hra1129/V9968_Cartridge/readme.md

# 概要
MSX2++用のVDP「V9968」の開発用リポジトリです。

# LICENSE
MIT License

# 免責事項
自動車等の乗り物や、医療、軍事等、人命にかかわるようなものへ、
一部または全部を転用する行為は厳禁です。
