hra1129/V9968_Cartridge/labo/readme.txt

ここには、実験用の回路を置きます。
This is where I place the experimental circuit.
