hra1129/V9968_Cartridge/pcb/vdp_cartridge_20k_3rd/readme.md

# メモ
	この基板には下記の問題がある。

	(1) HB-F1XV などの本体でカートリッジスロットと TangNano20K が干渉する
		おそらく、他にも干渉する本体は存在する。

	(2) JP1 が open で Lレベルになる想定だが TangNano20K上で PullUp されており 88h を選べない
		JP1 の右側のピンを GND にショートすれば 88h になる。
