hra1129/V9968_Cartridge/fpga/V9968_Cartridge_TangNano20K/src/v9968/doc/block_diagram.pdf

# MSX2++ Block Diagram

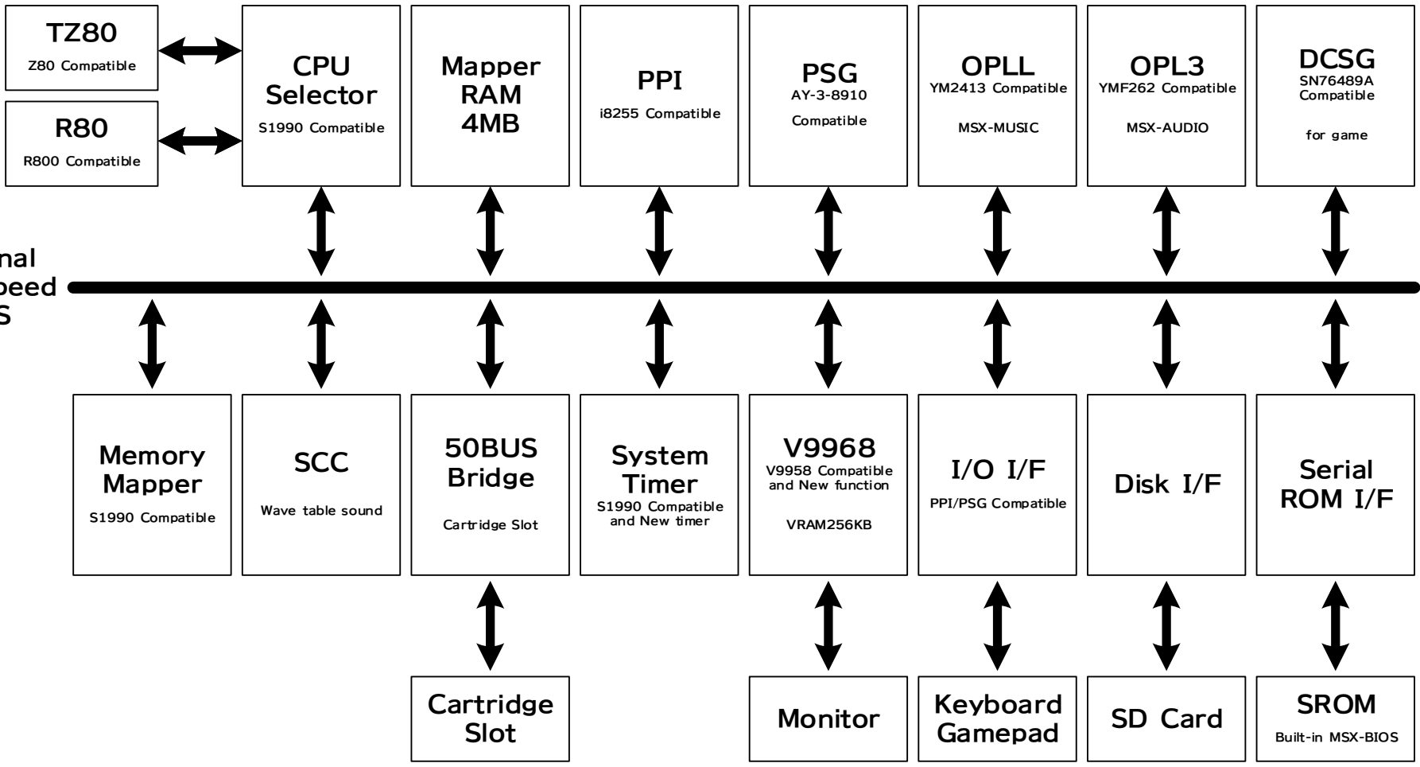
[picture p1: figure]
Z80 Compatible; R800 Compatible; CPU Selector; S1990 Compatible; Mapper RAM 4MB; PPI; i8255 Compatible; PSG; Compatible; OPLL; YM2413 Compatible; MSX-MUSIC; OPL3; YMF262 Compatible; MSX-AUDIO; DCSG; SN76489A Compatible; for game; V9958 Compatible and New function; VRAM256KB; 50BUS Bridge; Ca rtridge Slot; System Timer; S1990 Compatible and New timer; PPI/PSG Compatible; Keyboard; Gamepad Monitor Cartridge Slot; Disk I/F; Serial ROM I/F; SD Card; SROM; Built-in MSX-BIOS; SCC; Wave table sound; Memory Mapper

# Internal high speed BUS

# MSXturboR+ Block Diagram

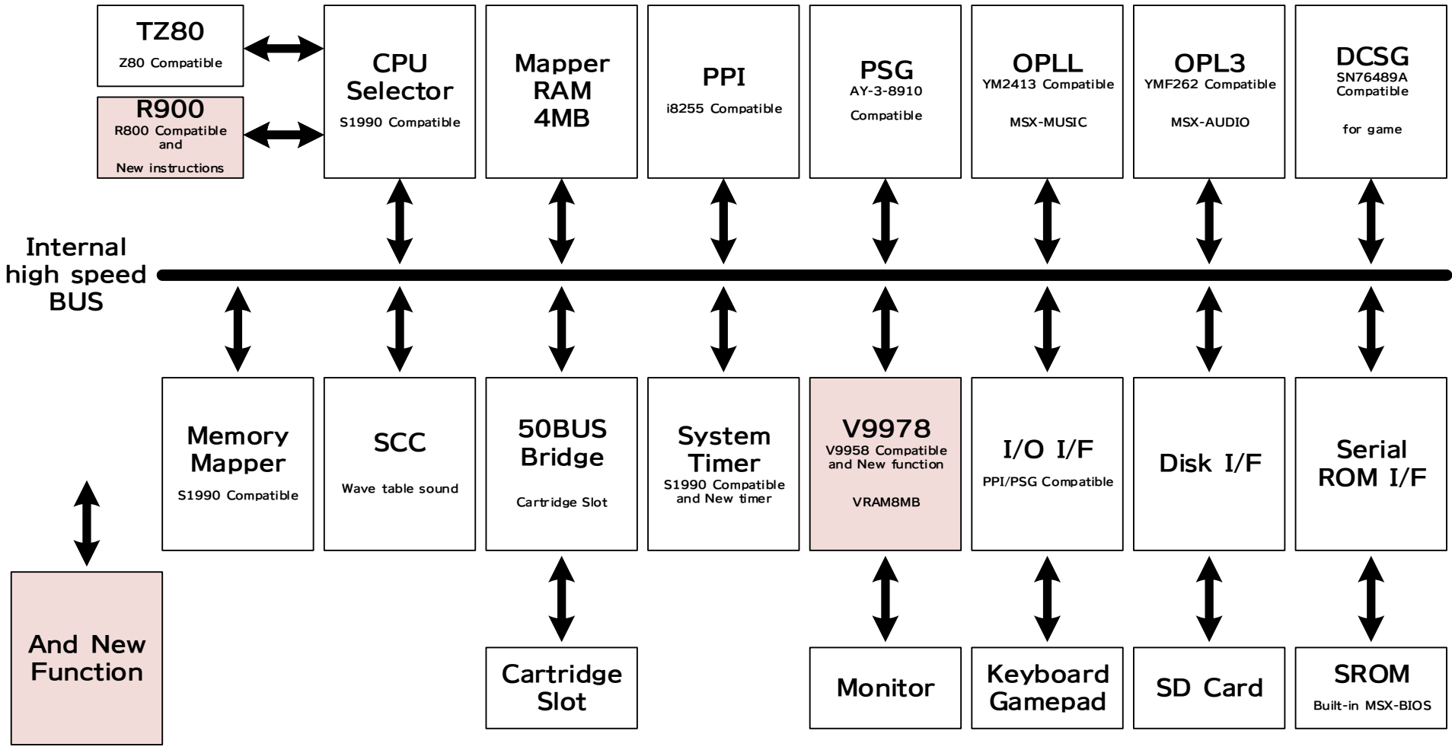
[picture p2: figure]
Z80 Compatible; R800 Compatible and; New instructions; CPU Selector; S1990 Compatible; Internal high speed BUS; Mapper RAM 4MB; PPI; i8255 Compatible; PSG; Compatible; OPLL; YM2413 Compatible; MSX-MUSIC; OPL3; YMF262 Compatible; MSX-AUDIO; DCSG; SN76489A Compatible; for game; V9958 Compatible and New function; VRAM8MB; 50BUS Bridge; Ca rtridge Slot; System Timer; S1990 Compatible and New timer; PPI/PSG Compatible; Keyboard; Gamepad Monitor Cartridge Slot; Disk I/F; Serial ROM I/F; SD Card; SROM; Built-in MSX-BIOS; SCC; Wave table sound; Memory Mapper; And New Function
