hra1129/V9968_Cartridge/fpga/V9968_Cartridge_TangNano20K/src/v9968/doc/v9968_compatibility_list.pdf

# | title | media | date | ok/ng | note 1 蒼き狼と白き牝鹿・元朝秘史 | ROM | 2026/1/4 NG | 戦闘中に登場キャラクターの色がおかしい・四角くなる 2 蒼き狼と白き牝鹿・ジンギスカンROM | 2026/1/1 OK | 冒頭のみ確認 3 三国志 | ROM | 2026/1/1 OK | 冒頭のみ確認 4 三国志II | ROM | 2026/1/1 OK | 冒頭のみ確認 5 めぞん一刻 | ROM | 2026/1/1 OK | 冒頭のみ確認 6 めぞん一刻・完結編 | ROM | 2026/1/1 OK | 冒頭のみ確認 7 うる星やつら | ROM | 2026/1/1 OK | 冒頭のみ確認 8 カオスエンジェルズ | DISK | 2026/1/4 NG | 冒頭から表示が崩れる 9 Ys | DISK | 2026/1/4 OK | 冒頭のみ確認

10 YsII | DISK | 2026/1/4 OK | 冒頭のみ確認
11 ワンダーラーズ・フロム・Ys | DISK | 2026/1/4 OK | 冒頭のみ確認
12 XeGrader | ROM | 2026/1/4 NG | ゲームの途中でフリーズする場合がある
13 ハイドライド3 (MSX1) | ROM | 2026/1/4 OK | 冒頭のみ確認
14 ハイドライド3 (MSX2) | ROM | 2026/1/4 OK | 冒頭のみ確認
15 アレスタ | ROM | 2026/1/4 OK | 冒頭のみ確認
16 アレスタ2 | DISK | 2026/1/4 OK | 冒頭のみ確認
17 フリートコマンダーII | ROM | 2026/1/4 NG | 起動時にフリーズ
18 英雄伝説 | DISK | 2026/1/4 OK | 冒頭のみ確認
19 イシターの復活 | ROM | 2026/1/4 OK | 冒頭のみ確認
20 信長の野望・武将風雲録 | ROM | 2026/1/4 OK | 冒頭のみ確認
21 キャッスルエクセレント | ROM | 2026/1/4 OK | 冒頭のみ確認
22 R-TYPE | ROM | 2026/1/4 OK | 冒頭のみ確認
23 スペースマンボウ | ROM | 2026/1/4 OK | 冒頭のみ確認
24 Xak | DISK | 2026/1/4 OK | 冒頭のみ確認
25 Xak2 | DISK | 2026/1/5 OK | 冒頭のみ確認
26 ロードス島戦記 | DISK | 2026/1/5 OK | 冒頭のみ確認
27 ロードス島戦記 福神漬け | DISK | 2026/1/5 OK | 冒頭のみ確認
28 ソーサリアン | DISK | 2026/1/5 NG | 街の武器屋の顔グラフィックに格子状に黒い帯が入る
29 ブンガルア | ROM | 2026/1/5 OK | 冒頭のみ確認
30 エメラルドドラゴン | DISK | 2026/1/5 OK | 冒頭のみ確認
31
32
33
34
