hra1129/V9968_Cartridge/pcb/vdp_cartridge_20k_4th/production/bom.csv

Designator | Footprint | Quantity | Value | LCSC Part #
R4, R5 | 0805 | 2 | 3.3kΩ | C26010
U1 | CLOCK | 1 | CLOCK 14.31818MHz | C2901565
C1 | 1210 | 1 | 100uF | C49066
R2 | 0805 | 1 | 10kΩ | C17414
Q1, Q2, Q3 | MOSFET(SMD) | 3 | NMOS | C2589
C2, C4, C5, C6, C7, C8, C9 | 0402 | 7 | 0.1uF | C1525
C3 | 0805 | 1 | 15pF | C63339
U4, U5, U6 | SSOP-24_5.3x8.2mm_P0.65mm | 3 | SN74LVC8T245DBR | C19197
