hra1129/V9968_Cartridge/pcb/vdp_cartridge_20k_4th/parts.txt

R4, R5 ....... 3.3Kohm						https://jlcpcb.com/partdetail/26753-0805W8F3301T5E/C26010
R2 ........... 10Kohm						https://jlcpcb.com/partdetail/18102-0805W8F1002T5E/C17414
Q1, Q2, Q3 ... TO236AB (MOSFET Nch)			https://jlcpcb.com/partdetail/InfineonTechnologies-IRLML2502TRPBF/C2589
U1 ........... CLOCK 14.318180MHz			https://jlcpcb.com/partdetail/3151378-SX3M1431818M20F30TNN/C2901565
C3 ........... 15pF							https://jlcpcb.com/partdetail/64402-0805CG150J500NT/C63339
C1 ........... 100uF						https://jlcpcb.com/partdetail/50074-CL32A107MQVNNNE/C49066
C2-C9 ........ 0.1uF						https://jlcpcb.com/partdetail/1877-CL05B104KO5NNNC/C1525
U4-U6 ........ SN74LVC8T245 SSOP			https://jlcpcb.com/partdetail/TexasInstruments-SN74LVC8T245DBR/C19197
U2 ........... TangNano20K					--
U3 ........... Card Edge Connector (N/A)
