hra1129/V9968_Cartridge/pcb/vdp_cartridge_20k_4th/garber/vdp_cartridge-Edge_Cuts.dxf

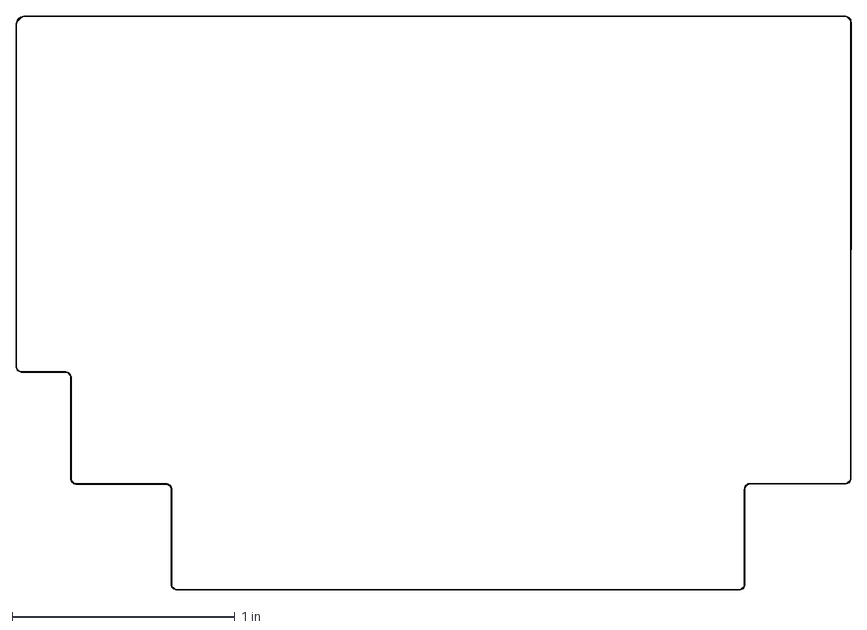
[picture p7: CAD file, 2026-10-30]
pcb/vdp_cartridge_20k_4th/garber/vdp_cartridge-Edge_Cuts.dxf
3.75 x 2.58 in
