hra1129/V9968_Cartridge/pcb/vdp_cartridge_20k_4th/garber/vdp_cartridge-F_Cu.dxf

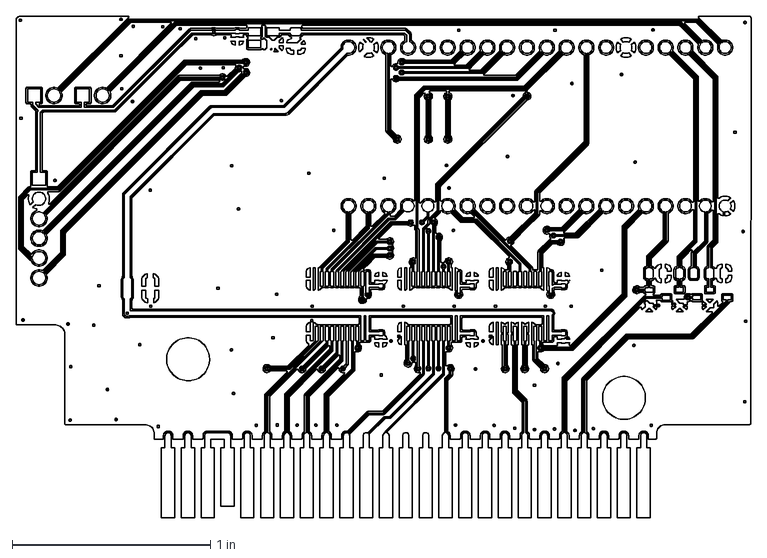
[picture p9: CAD file, 2026-10-30]
pcb/vdp_cartridge_20k_4th/garber/vdp_cartridge-F_Cu.dxf
3.71 x 2.53 in
