hra1129/V9968_Cartridge/(list of files, cad)

Other CAD files:
pcb/vdp_cartridge_20k_4th/garber/vdp_cartridge-B_Mask.dxf
pcb/vdp_cartridge_20k_4th/garber/vdp_cartridge-B_Silkscreen.dxf
pcb/vdp_cartridge_20k_4th/garber/vdp_cartridge-F_Mask.dxf
pcb/vdp_cartridge_20k_4th/garber/vdp_cartridge-F_Silkscreen.dxf
