hra1129/V9968_Cartridge/fpga/V9968_Cartridge_TangNano20K/src/v9968/manual/v9968_cartridge_manual.pdf

V9968 Cartridge; SiP EED; TA NG N ANO [20K]; 強制高速モードスイッチ; 左： ノーマル 右： 強制高速モード; 動作中の切り替え可。 ノーマルでは、ソフト側の設定によって切り替わる。 強制高速モードは、ソフト側の設定に関わらず高速モードになる。; I/Oマッピング切り替え 左: 88h～8Ch 右: 98h～9Ch (注意!); 動作中の切り替え不可。 MSX本体のVDPが無効な場合にのみ、右を選んでよい。 MSX本体のVDPが有効な状態で、右にして装着すると最悪MSX本体が壊れるので要注意。
