hra1129/V9968_Cartridge/fpga/V9968_Cartridge_TangNano20K/src/v9968/test_pattern/graphic2/test_item.pdf

TEST ITEM | test001_g2font (G2FONT.COM)
Confirmation Details | PCGフォント定義の確認


期待通りに動作すれば、左記の表示になる。
GRAPHIC2 における Pattern Generator Table のテストである。

If it operates as expected, the display will appear as shown on the left. This is a test of the Pattern Generator Table in GRAPHIC2.

TEST ITEM | test002_t2vscr (T2VSCR.COM)
Confirmation Details | 垂直スクロールの確認

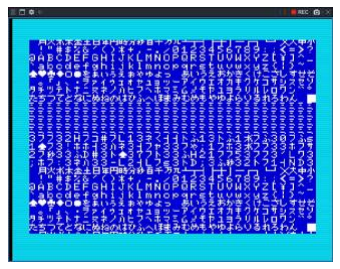
[picture p357: figure]

期待通りに動作すれば、左記の表示になり、フォント形状だけが垂直方向にスクロールする。 GRAPHIC2 における R#23 のテストである。

If it works as expected, the display will appear as shown in the left figure, with only the font shapes scrolling vertically.
This is a test for R#23 in GRAPHIC2.

TEST ITEM | test003_g2hscr (G2HSCR.COM)
Confirmation Details | 水平スクロールの確認

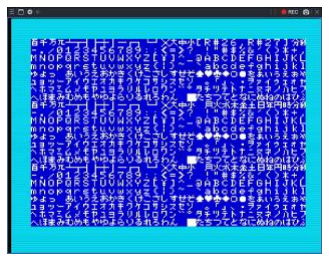
[picture p358: figure]

期待通りに動作すれば、左記の表示になる。
最初の画面は、左上に [R#26,R#27] と表示され、画面全体が左へスクロール。 止まってからスペースキーを押すと次の画面へ遷移。
2番目の画面は、左上に [R#27 only] と表示され、ゆっくり左へ8ドットスクロールを繰り返す。 止まってからスペースキーを押すと次の画面へ遷移。
3番目の画面は、左上に [R#26 only] と表示され、画面全体が左へ8ドット単位のスクロール。 しばらくしてからスペースキーを押すと次の画面へ遷移。
4番目の画面は、左上に [R#27 MASK] と表示され、ゆっくり左へ8ドットスクロールを繰り返す。 止まってからスペースキーを押すと終了する。

If it operates as expected, the display will appear as shown on the left.
The first screen displays [R#26,R#27] in the upper left corner, and the entire screen scr olls left.
Pressing the space key after it stops advances to the next screen.
The second screen displays [R#27 only] in the upper left corner and repeatedly scrolls slowly left by 8 dots.
Pressing the space key after it stops advances to the next screen.
The third screen displays [R#26 only] in the upper left corner, and the entire screen scr olls left in 8-dot increments.
Press the space key after a short delay to advance to the next screen.
The fourth screen displays [R#27 MASK] in the upper left corner and slowly scrolls left in 8-dot increments repeatedly.
Press the space key after it stops to exit.

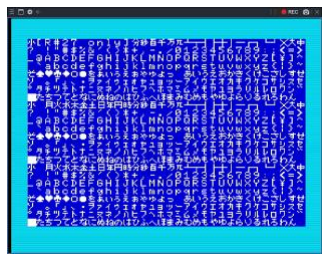
[picture p359: figure]
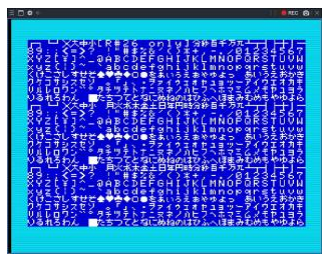
[picture p360: figure]
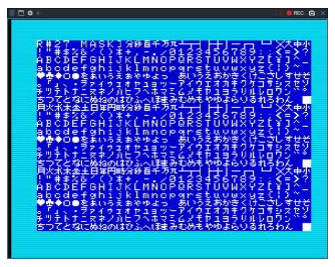
[picture p361: figure]

TEST ITEM | test004_g2adj (G2ADJ.COM)
Confirmation Details | 画面位置調整の確認

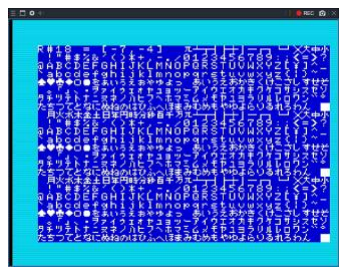
[picture p362: figure]

期待通りに動作すれば、左記の表示になる。
左上には R#18 = [x,y] の表示があり、x と y ともに -8 からインクリメントして 7 まで変化する。 それに合わせた画面表示になることを確認する。
[-8,-8] が右下、[7,7] が左上に寄った表示となるのが正しい。
[7,7] で停止するが、スペースキーを押すと次へ遷移する。
もう一度同じ動きをするが、2回目は左端が 8ドットマスクされた状態となる。 R#18 = [x,y] の R が隠れている状態で、[7,7] まで動く。
停止後、スペースキーを押すと終了する。

If it operates as expected, the display will appear as shown on the left.
The top-left shows R#18 = [x,y], where both x and y increment from -8 to 7. Confirm that the screen display matches this.
The correct display is [-8,-8] in the bottom-right and [7,7] shifted toward the top-left.
It stops at [7,7], but pressing the spacebar advances to the next state.
It repeats the same movement, but the second time, the left edge is masked by 8 dots.
It moves to [7,7] with the R in R#18 = [x,y] hidden.
After stopping, pressing the spacebar ends the sequence.

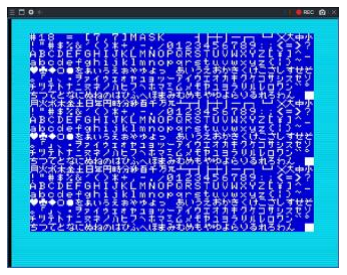
[picture p363: figure]

TEST ITEM | test005_g2sp1 (G2SP1.COM)
Confirmation Details | Sprite mode1 の動作確認

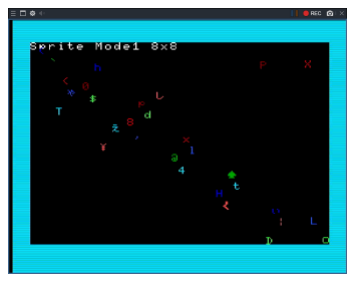
[picture p364: figure]
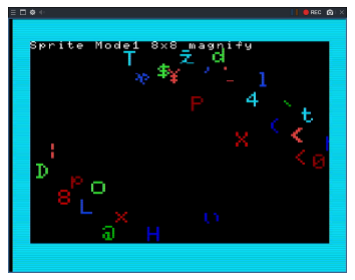
[picture p365: figure]
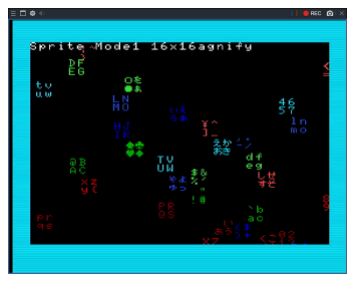
[picture p366: figure]
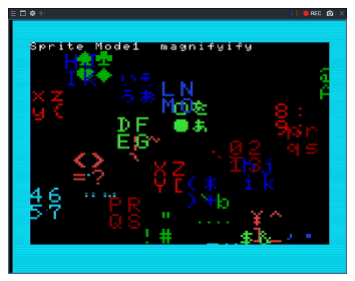
[picture p367: figure]

TEST ITEM | test006_g2sp2 (G2SP2.COM, image1.SC5)
Confirmation Details | Sprite mode3 の動作確認

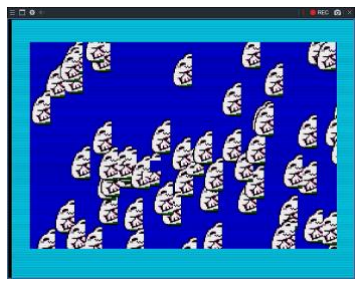
[picture p368: figure]

TEST ITEM | test005_g2sp3 (G2SP3.COM)
Confirmation Details | Sprite mode1 の LEFT MASK 動作確認

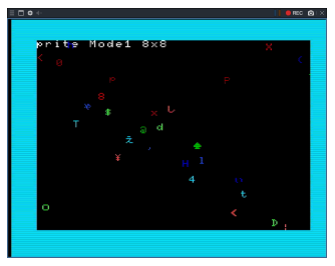
[picture p369: figure]
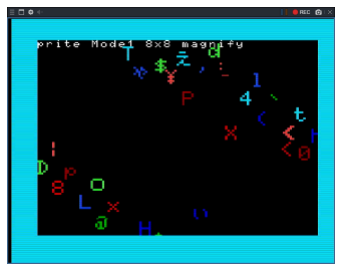
[picture p370: figure]
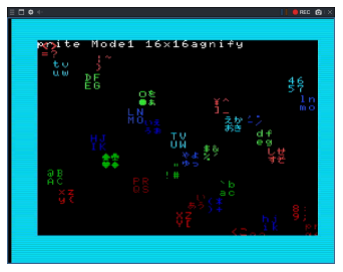
[picture p371: figure]
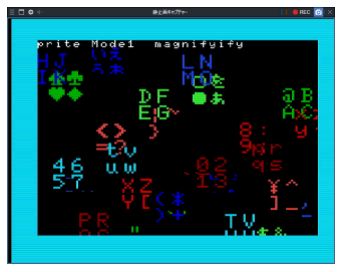
[picture p372: figure]

TEST ITEM | test008_g2sp4 (G2SP4.COM, image1.SC5)
Confirmation Details | Sprite mode3 の LEFT MASK 動作確認

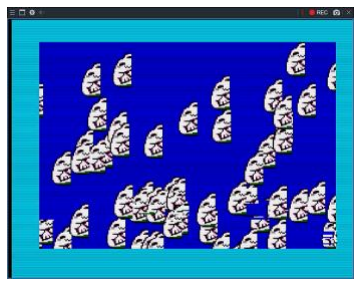
[picture p373: figure]

TEST ITEM | test009_g2img (G2IMG.COM, RABBIT.SC2)
Confirmation Details | PCG定義が正常に行われることの確認。

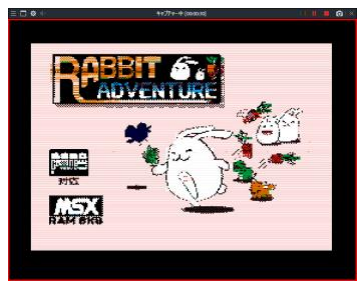
[picture p374: figure]
