hra1129/V9968_Cartridge/fpga/V9968_Cartridge_TangNano20K/src/test_top_SCREEN6_LOGO/logo_lines.csv

frame | scroll | line | exp_r26 | exp_r27 | eff_r26 | eff_r27 | verdict | delta_dots | coll_x | coll_to_cread_T | coll_to_r27_T | r27_write_x | margin26_dots | margin27_dots | latch_count | latch_x
0 | 225 | 31 | 29 | 7 | 36 | 1 | STALE | 62 | 232 | 17 | 62 | -359 | 379 | 358 | 1 | -1
0 | 225 | 32 | 36 | 1 | 29 | 7 | STALE | -62 | 232 | 12 | 57 | -366 | 386 | 365 | 1 | -1
0 | 225 | 33 | 29 | 7 | 36 | 1 | STALE | 62 | 232 | 7 | 52 | -373 | 393 | 372 | 1 | -1
0 | 225 | 34 | 36 | 1 | 29 | 7 | STALE | -62 | 232 | 3 | 47 | -381 | 400 | 379 | 1 | -1
0 | 225 | 35 | 29 | 7 | 36 | 1 | STALE | 62 | 232 | 29 | 73 | -341 | 361 | 340 | 1 | -1
0 | 225 | 36 | 36 | 1 | 29 | 7 | STALE | -62 | 232 | 24 | 69 | -349 | 368 | 347 | 1 | -1
0 | 225 | 37 | 29 | 7 | 36 | 1 | STALE | 62 | 232 | 19 | 64 | -356 | 376 | 355 | 1 | -1
0 | 225 | 38 | 36 | 1 | 29 | 7 | STALE | -62 | 232 | 14 | 59 | -363 | 383 | 362 | 1 | -1
0 | 225 | 39 | 29 | 7 | 36 | 1 | STALE | 62 | 232 | 9 | 54 | -370 | 390 | 369 | 1 | -1
0 | 225 | 40 | 36 | 1 | 29 | 7 | STALE | -62 | 232 | 5 | 49 | -378 | 397 | 376 | 1 | -1
0 | 225 | 41 | 29 | 7 | 36 | 1 | STALE | 62 | 232 | 31 | 75 | -338 | 358 | 337 | 1 | -1
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
