hra1129/V9968_Cartridge/fpga/V9968_Cartridge_TangNano20K/src/v9968/soft_vdp_test/sc5rot.xlsx

0 | dw | 256 | 0
1 | dw | 255 | 4
2 | dw | 255 | 8
3 | dw | 255 | 13
4 | dw | 255 | 17
5 | dw | 255 | 22
6 | dw | 254 | 26
7 | dw | 254 | 31
8 | dw | 253 | 35
9 | dw | 252 | 40
10 | dw | 252 | 44
11 | dw | 251 | 48
12 | dw | 250 | 53
13 | dw | 249 | 57
14 | dw | 248 | 61
15 | dw | 247 | 66
16 | dw | 246 | 70
17 | dw | 244 | 74
18 | dw | 243 | 79
19 | dw | 242 | 83
20 | dw | 240 | 87
21 | dw | 238 | 91
22 | dw | 237 | 95
23 | dw | 235 | 100
24 | dw | 233 | 104
25 | dw | 232 | 108
26 | dw | 230 | 112
27 | dw | 228 | 116
28 | dw | 226 | 120
29 | dw | 223 | 124
30 | dw | 221 | 128
31 | dw | 219 | 131
32 | dw | 217 | 135
33 | dw | 214 | 139
34 | dw | 212 | 143
35 | dw | 209 | 146
36 | dw | 207 | 150
37 | dw | 204 | 154
38 | dw | 201 | 157
39 | dw | 198 | 161
40 | dw | 196 | 164
41 | dw | 193 | 167
42 | dw | 190 | 171
43 | dw | 187 | 174
44 | dw | 184 | 177
45 | dw | 181 | 181
46 | dw | 177 | 184
47 | dw | 174 | 187
48 | dw | 171 | 190
49 | dw | 167 | 193
50 | dw | 164 | 196
51 | dw | 161 | 198
52 | dw | 157 | 201
53 | dw | 154 | 204
54 | dw | 150 | 207
55 | dw | 146 | 209
56 | dw | 143 | 212
57 | dw | 139 | 214
58 | dw | 135 | 217
59 | dw | 131 | 219
60 | dw | 128 | 221
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
