hra1129/V9968_Cartridge/fpga/V9968_Cartridge_TangNano20K/src/v9968/test_pattern/graphic6/A1man.CSV

 | MSX PALETTE DATA(&Hrb,&H0g)
00,00,11,01,33,03,31,02,16,04,25,03,21,02,13,02,10,01,63,06,63,03,52,04,24,04,10,00,63,02,77,07
