hra1129/V9968_Cartridge/fpga/V9968_Cartridge_TangNano20K/src/history.md

## 2026-11-14 VDPVIEW に SC8 + SP3 の固定色・半透明のページ（P18）を追加し、test_vdp_sprite_info_collect を現在のポートで書き直し

- **VDPVIEW P18「V9968 SC8 SP3 FIXED COLOR」**（V9968 専用、R#20=08h、EPAL=0）
  - 4行の GRB332 背景（9Ch、F0h、93h、1Dh）の上に、固定色10、12、9、8 の SP3 スプライトを TP0〜3 で置いた。各スプライトのパレットセットは1〜16（無視されることの確認）。
  - 背景とスプライト色の組は、TP0〜3 のすべての合成結果がちょうど GRB332 で表せるものを選んだ。スプライトのすぐ下に、その GRB332 値の見本を描いている。正しければ、スプライトと見本の間につなぎ目が見えない。
  - 既存のページ番号を変えないように末尾に追加した。openMSX は SP3 を描画しないため、資料には期待画像（`img/p18.png`）だけを載せた。
  - 変更：`gen_vdpview.py`、`vdpview_doc.py`。`VDPVIEW.COM`/`.INC`/`.md` は再生成した（COM は 50,429 バイト）。
- **`test_vdp_sprite_info_collect`**：古いポート（screen_active、13ビットの screen_pos_x など）のままで動かなかった。現在の RTL のポートで、自己判定するベンチに書き直した。
  - VRAM モデルは、アドレスから決まるデータを要求の4クロック後に返す（それまでは X）。
  - 確認すること：
    - VRAM 要求アドレスの並び。
    - color、plane_x、y、mgx、mgy、bit_shift、palette_set、pattern（左右）、makeup_plane。
    - 収集したプレーン数。
  - ケース：SP1 8x8、SP1 16x16、SP2 16x16（SAT[8:7]=11/01）、SP2 8x8、SP3 16プレーン/3プレーン、selected_count=0、表示 OFF、表示 OFF の後に ON。
  - RTL は変えていない。全ケースが PASS。
  - わざと RTL を壊したコピー（SP3 の右パターンのアドレス、SP2 のカラーアドレスの Y）では、該当するケースが NG になることを確認した。
  - `run.bat` は `vsim -c -t 1ns` で動かし、PASS 行がなければ exit 1 で終わる（`pause` は削除）。`run.do` は使わなくなったので削除した。
- コミットはユーザーが行う。

### 次回の作業

- 実機（SX-2 + V9968）で VDPVIEW P18 を確認する。

## 2026-11-14 SCREEN8（EPAL=0）の SP3 で半透明が効かない不具合を修正し、マニュアルのスプライト色の記述を訂正

- **仕様**：SCREEN8（Graphic7、EPAL=0、YJK=0）では、スプライトモード2 も3 も V9958 と同じ固定16色を使う。パレットセットの指定は無効。SP3 の半透明（TP0〜3）は有効で、固定色と背景（GRB332）を混ぜる。パレットを通るのは EPAL=1 のときだけ。
- **不具合（`vdp_color_palette.v`）**：SC8 の RGB 経路（`ff_display_color256`）が出力の選択で常に優先されていた。そのため SP3 の合成結果（`ff_display_*16`）が捨てられ、半透明が効かずに常に不透明になっていた。
- **修正**：SC8・EPAL=0・SP3（`w_g7_rgb_sp3`）のときだけ、次のようにした。
  - 背景の GRB332（`ff_display_bg256`、sub phase 1 で取り込む）を 5 ビットの RGB に広げて `ff_display_*16` に入れる。
  - 固定16色のスプライト色を 5 ビットに広げ、`func_sprite_mix` で合成する。
  - SP2 と、SC8 以外のモードは変えていない。
- **マニュアル**（`doc/manual/V9968_MSX-VIDEO_Technical_data_Book*.odt`、日本語版・英語版）：§6.4.4、§7.4.3、§7.4.7 の「SC8 のスプライトもパレット経由」という誤りを、上の仕様に直した。§7.4.3 には固定16色の GRB332 の値を書いた。PDF の出力はユーザーが行う。
- **テスト**：`test_vdp_color_palette/tb.sv` に、SC8・SP3 の固定色（TP0、パレットセット指定 A は無視）、TP2 の 50% 合成、スプライトなしの3ケースを追加した。修正前の RTL では失敗し（8BBFB0 を期待して 007B5A）、修正後は tb と tb_screen8_mask が PASS。
- **Gowin 1.9.12.03**：Logic 81%、CLS 95%。
  - 標準の設定では、SDRAM の読み出し経路（`ff_main_state` → `ff_sdr_read_data` の CE、clk85m→clk_sdram）が −0.235ns になった。配置の変化によるもので、今回の修正箇所ではない。
  - ユーザーが合成オプションを変えたビルドではパスした。
- 変更ファイル: `v9968/vdp_color_palette.v`、`v9968/test_vdp_color_palette/tb.sv`、`doc/manual/*.odt`、`history.md`。
- コミットはユーザーが行う。

### 次回の作業

- 【済】実機で SC8 + SP3 の半透明を確認する（VDPVIEW には SC8・SP3 のページがない）。→ P18 を追加。実機確認は残っている。
- 【済】`test_vdp_sprite_info_collect` のテストベンチのポートが RTL と合っていない（以前からの問題）。

## 2026-11-14 SP3 の上端のスプライトで、ライン0が欠ける不具合を修正

- **症状**：VDPVIEW P14（SC5 + SP3、R#20=08h）で、Y=−8 で上端にかかったスプライトのライン0だけが表示されなかった。
- **原因（`vdp_sprite_select_visible_planes.v`）**
  - ライン0 に表示するスプライトは、ライン −1 の間に選ぶ。
  - SVNS=1 では screen_pos_y を符号付きで使うので、ライン −1 は −1 になり正しかった。
  - SVNS=0 では、8ビットの pixel_pos_y＝(−1+R#23) mod 256＝255 を `{0, pixel_pos_y}` として、SP3 の10ビットの Y と比べていた。そのため Y=1015（−9）、MGY=16 のスプライトが、ライン0 で非表示と判定された（オフセットが 8 ではなく 264 になる）。
  - SP1/2 は比較が8ビットの周回なので問題ない。
- **修正**：SP3 で SVNS=0 のときだけ、次の条件を満たす pixel_pos_y を負の座標（pixel_pos_y−256）として扱う。
  - 条件：screen_pos_y が負で、R#23 を足しても桁上がりしない（`pixel_pos_y >= screen_pos_y[7:0]`）。
  - R#23=0 のライン −1 は −1 になり、データブックの「Y=−1 でライン0 から表示」と一致する。
  - SP1/2 と SVNS=1 は変えていない。
  - 制限：R#23≠0 のとき画面途中にできる背景の周回の継ぎ目（pixel_pos_y が 255→0）をまたぐ SP3 スプライトは、継ぎ目で途切れる。
- **テスト**
  - `test_vdp_sprite_makeup_pixel/tb_r23.sv` に、SP3・SVNS=0・Y=−9・MGY=16 のライン −1 の選択テストを追加した（R#23=0/1 では選ばれる、20 では選ばれない）。
  - 修正前の RTL では失敗し、修正後は合格する。
  - `test_vdp_sprite_makeup_pixel`（tb、tb_r23）と `test_vdp_sprite_select_visible_planes` が PASS。
- Gowin 1.9.12.03 でビットストリーム生成まで完了。setup の最小 slack は +0.317ns、hold は +0.062ns、違反端点は0。Logic 82%。
- 変更ファイル: `v9968/vdp_sprite_select_visible_planes.v`、`v9968/test_vdp_sprite_makeup_pixel/tb_r23.sv`、`history.md`。
- コミットはユーザーが行う。

### 次回の作業

- 【済】実機で VDPVIEW P14 の上端の赤い線が消えたことを確認した。
- 【保留】VDPVIEW が P06→P07 の切り替え中（表示 OFF のまま）に1回だけハングした。その後の約13回の実行では再現しない。VDPCHK と VRAMSTRS は `SUCCESS OF ALL`。
  - この区間では SP3 は OFF なので、今回の修正部分は動いていない。
  - 次にハングしたら、基板の LED の状態を確認する。
    - シアンのまま点灯している場合：CPU は S#2 の CE を待ち続けている（HMMV の CE が下がらない）。
    - 消灯している場合：CPU が WAIT で止まったか、暴走している。

## 2026-11-14 VDPVIEW・VRAMSTRS を作成し、バスの書き込みデータ取り込みと YJK モードの周辺色を修正

- **VDPVIEW.COM（`test/VDPVIEW/`）目視確認テスト**
  - `gen_vdpview.py` がページ定義（レジスタ、パレット、VRAM の画像、表示方法）からバイトコード（`VDPVIEW.INC`）と確認手順書 `VDPVIEW.md` を生成する。`VDPVIEW.ASM` のインタプリタがそれを実行する。`build.bat` でビルドする。
  - 全17ページ。スプライトの端（全モード・拡大）、スプライトの色・TP・CC、SC6/SC8/SC11/SC12 の周辺色、走査線割込みによる周辺色・スクロールの変更、HR/VR のポーリング、V9968 専用（SP3、EPAL）。V9958 では V9968 専用ページを飛ばす。
  - P01〜P13 は実機 V9958（FS-A1GT）のキャプチャと openMSX の見え方が一致することを確認した。P17（SC12）は後から追加したため、既存のページ番号は変えていない。
- **VRAMSTRS.COM（`test/VRAMSTRS/`）高負荷テスト**
  - CPU による VRAM の連続読み書きを、VDP の高負荷状態で繰り返して比較する。`VRAMSTRS [rounds]`、0 は ESC まで。不一致は W（書き込み化け）、R（読み出し化け）、?（不明）に分類して表示する。
- **バスの書き込みデータ取り込み（`msx_slot/msx_slot.v`）**
  - SX-2 + V9968 で VRAMSTRS が W エラー（D0/D1 が 1→0 に化ける。データとアドレスの両方）を出した。同期後の /WR が下がってから約35〜46ns でデータを取り込んでおり、データの立ち上がりが遅い本体では間に合わなかった。
  - /WR が下がってから8クロック（clk85m）待ってからデータを1回だけ取り込むようにした。待つ間も WAIT は出し続ける。
  - `v9968/test_vram_prefetch_wait` にテスト [10]（D0/D1 が80ns 遅れて立ち上がる書き込み）を追加した。修正前は失敗、修正後は合格。
  - 実機：VRAMSTRS は3周とも `SUCCESS OF ALL`。VDPVIEW の P04/P08/P09 のランダムな化けも消えた。
- **SCREEN10/11/12 の周辺色（`vdp_timing_control_screen_mode.v`、`vdp_color_palette.v`）**
  - 周辺色の領域では、screen_mode が R#7 の8ビットを画素として `display_color_en=1` のまま出している（SCREEN0〜8 はこれで正しい）。palette の YJK 分岐がこれを映像の画素として扱い、SCREEN10/11 では YAE の画素（R7 bit3 で パレット/YJK）として、SCREEN12 では YJK として表示していた。v0.99.2 より前からの不具合。
  - screen_mode に周辺色の画素を示す `display_color_border`（`!ff_pattern_valid` を sub phase 15 で取り込む）を追加し、palette の YJK 分岐だけで使うようにした。SCREEN0〜8 の経路は変えていない。
  - SCREEN12 では `w_yjk_background` が YAE=0 のときに常に YJK を選んでいた。bit8（周辺色の印）が立っていればパレットを使うようにし、周辺色は YAE によらず R#7[3:0] のパレット色にした（MSK の領域、表示 OFF も含む）。
  - `test_vdp_color_palette/tb.sv` の SCREEN12 の周辺色の期待値（YJK として解釈した色 404052）を、正しいパレット色に直した。YJK モードの周辺色の画素のテストを追加した。
  - 回帰：`test_vdp_color_palette`（tb、tb_screen8_mask）が PASS。`test_top_SCREEN5_LMCM` が PASS。
- Gowin 1.9.12.03 でビットストリーム生成まで完了。setup の最小 slack は +0.181ns、hold は +0.074ns、違反端点は0。Logic 82%。
- 変更ファイル: `msx_slot/msx_slot.v`、`v9968/vdp.v`、`v9968/vdp_timing_control.v`、`v9968/vdp_timing_control_screen_mode.v`、`v9968/vdp_color_palette.v`、各テストベンチ、`test/VDPVIEW/*`、`test/VRAMSTRS/*`、`history.md`。
- コミットはユーザーが行う。

### 次回の作業

- 実機（SX-2 + V9968）で VDPVIEW の P10（SC11）と P17（SC12）の周辺色が期待どおりになったことを確認済み。
- SP3 で Y=−8 のスプライトのライン0が欠ける不具合（VDPVIEW P14 の上端の赤）を調べる。

## 2026-11-14 DOS 用自己判定テスト VDPCHK.COM を作成し、見つかった VDP コマンドの不具合7件を修正

v0.99.6 と v0.99.7 がリリースされた。v0.99.7 の内容は、FG4=1 のとき全 VDP コマンドを SCREEN5 と同じ解像度・ビット深度で動かすこと、SP3=0 の LFMM のフォント読み出しを CPU と同じインターリーブ前提にすること、`test_vdp_timing_control_ssg` へのポート追加。

- **VDPCHK.COM（`test/VDPCHK/`）**
  - `gen_vdpchk.py` は openMSX（VDPCmdEngine.cc）準拠の参照モデルで、期待 CRC を埋め込んだテストのバイトコード（`VDPCHK.INC`）と `test_item.md` を生成する。`VDPCHK.ASM` のインタプリタがバイトコードを実行し、VRAM を CPU で読み戻した CRC-16 で判定する。`build.bat` でビルドする。
  - 最後に「不一致数/全数」と失敗したテスト番号を表示する。不一致0なら `SUCCESS OF ALL` を表示する。終了時は画面をテキストに戻して DOS に戻る。
  - 全769件。CPU による VRAM 読み書き（R#14 の値を数パターン）、全コマンド、DIX/DIY の全組み合わせ、画面はみ出し、NX/NY=0、LINE の斜め線、SRCH の見つかった・見つからないときの S#2/S#8/S#9、SCREEN5〜8/10/12、SCREEN0〜4 での CMD=1、全モードでの FG4=1 を含む。V9968 専用のセクション（FG4 など）は V9958 ではスキップする。
  - RTL での突き合わせ用に `v9968/test_vdpchk`（tb.sv、run.bat）を追加した。同じバイトコードを ModelSim で実行する。
- **見つかった RTL の不具合7件（`vdp_command.v`、openMSX と V9958 の動作に合わせた）**
  1. LMCM で DIY=1 のとき1ラインで終了していた。終了判定に使われない DY のオーバーフローを見ていた。SY のオーバーフローで判定するようにした。
  2. LINE で NY>NX のとき、ASX を10ビットに丸めていなかった。
  3. LINE の X 主軸・DIY=1 で、Y=0 の最初の点で終了していた。Y を −1 へ進めるときに終了するようにした。
  4. R#44 の色をビット深度でマスクしていなかったため、TIMP などの透明判定と SRCH の比較が誤っていた（FG4 の LMMC TIMP も含む）。
  5. V58=1（128KB）の SC7/SC8 で、Y=512 が折り返さずにアドレスの bit17 が残っていた。
  6. NY=0 が1023ラインになっていた。1024ラインにした。
  7. CMD=0 の SCREEN0〜4 でもコマンドが実行されていた。FG4=1 であっても CMD=0 なら実行せず、すぐに終了する（V9958 と同じ）。
- ModelSim の VDPCHK ベンチで全769件が一致した（`# SUCCESS OF ALL`）。全域 HMMV（180）は単独で約15分かかるため、tb.sv の既定のポーリング上限を 16000000 に上げた。
- 回帰：`test_vdp_command`（tb、tb_flushend）が PASS。
- Gowin 1.9.12.03 でビットストリーム生成まで完了。setup の最小 slack は +0.016ns、hold は +0.074ns、違反端点は0。Logic 82%。
- 変更ファイル: `v9968/vdp_command.v`、`v9968/test_vdpchk/*`、`test/VDPCHK/*`、`history.md`。
- 実機確認：FS-A1GT（turboR、V9958）で `RESULT: 0/559`、`SUCCESS OF ALL`（V9968 専用の210件はスキップ）。SX-2 + V9968 でも `SUCCESS OF ALL`。参照モデルが V9958 実機と一致することと、修正後の RTL が全769件で正しく動くことを確認した。
- コミットはユーザーが行う。

### 次回の作業

- VDP コマンドを修正したときは、VDPCHK.COM（または `v9968/test_vdpchk` のベンチ）で回帰を確認する。
- setup の余裕が +0.016ns と少ない。次の修正でビルドしたときに違反が出たら、その最悪経路だけを直す。

## 2026-11-14 hesoten さんの新しい報告3件を修正（色0と TP、S16 の偽衝突、LFMM の画面端と NX）

ユーザーが v0.99.5 の実機動作を確認した。hesoten さんの報告リポジトリ（`hra_report`、89a2de6）に追加された未対応3件を修正した。

- **B02 SpriteMode2 の S16=1 で偽の衝突（`vdp_sprite_select_visible_planes.v`）**
  - S16=1（SpriteMode1/2）のとき、選択の打ち切りが `ff_selected_count[4]`（16枚選んだ）だけで、32枚を走査し終えた判定（`ff_plane_count[5]`）がなかった。16枚未満のラインでは33番目の読み出しがプレーン0に戻り、同じプレーンがもう一度選ばれて自分自身と衝突していた。
  - S16 のときは `ff_selected_count[4] | ff_plane_count[5]` で選択を打ち切るようにした（報告のパッチと同じ）。SpriteMode3 は従来どおり。
  - 提供ベンチ `tb_s16.sv` の20ケースを ModelSim で修正前後とも実行した。修正前は S16=1 の7ケースで偽の衝突（C=1）、s16_hit は衝突座標が誤り（X=112・Y=108）。修正後は全ケースが期待値（C=0、s16_row17 は 90h、s16off_row9 は 88h、s16_hit は X=120・Y=112）。SCREEN1/5 の映像チェックサムは修正前と一致し、SCREEN8 の映像は S16=0 と同じになった。
- **B03 LFMM の画面端で固まる・NX を文字数として数えない（`vdp_command.v`）**
  - 画面端（`w_dx_overflow`）を文字の行の終わりとしても扱い、フォントアドレス・NY・状態遷移を進めるようにした。画面端で固まっていた5ケースが終わるようになった。
  - NX は文字数として数える（文字の最後の行・最後のビットで +1）。LFMM 中に `reg_nx` を書き換える処理を削除し、終了条件も「最後の文字のビット0」か画面端で判定する。
  - 提供ベンチ `tb_lfmm.sv` の21ケース：修正前は model_diff>0 が多数、5ケースで CE が落ちなかった。修正後は全ケースで model_diff=0、CE も落ちる。
  - SCREEN6/7、DIY=1、FG4、NY=0 は報告でも未確認で、今回も未確認。
- **06 テキスト・マルチカラーの色0と TP（`vdp_timing_control_screen_mode.v`、`vdp_color_palette.v`）**
  - Text1/Text2 の文字の前景色が0なら、その文字の背景色（普通の文字は R#7、ブリンク欄は R#12 の下位4ビット）で描く。TP には関係なく適用する。Text1 は Graphic1〜3 と共通だった式から分けた。ブリンク欄の背景色0は実機どおりパレット0のまま。
  - Multicolor の色0は、TP=1 でも周辺色にする。
  - TPTEST 相当の色0ベンチ（セッション内で作成、14ケース）で、修正前は報告の差1〜3がすべて再現し、修正後は実機の結果と一致した。前景色0を含まないケース（Text の前景色15、SCREEN2 の TP=0/1）は修正前後で同じ。
- 回帰：`test_vdp_command`、`test_vdp_color_palette`、`test_vdp_sprite_makeup_pixel`、`test_vdp_sprite_select_visible_planes` が PASS。`test_vdp_timing_control_ssg` は以前のポート追加にベンチが追従しておらず読み込みで失敗する（既存の問題で今回の変更とは無関係）。
- Gowin 1.9.12.03 でビットストリーム生成まで完了。setup の最小 slack は +0.156ns（スプライトの `u_divide_table` → `u_makeup_pixel` の経路）、hold は +0.074ns、全クロックの TNS・違反端点は0。Logic 81%。setup の余裕が v0.99.5 より増えたので、タイミング対策は行っていない。
- 変更ファイル: `v9968/vdp_sprite_select_visible_planes.v`、`v9968/vdp_command.v`、`v9968/vdp_timing_control_screen_mode.v`、`v9968/vdp_color_palette.v`、`history.md`。
- 実機は未確認。コミットはユーザーが行う。

### 次回の作業

- 実機で確認する：TPTEST/TPTEST2、スプライト16枚モード（S16）のゲーム、LFMM を使うソフト、起動ロゴ・SCREEN5〜8 の表示。
- `test_vdp_timing_control_ssg` のベンチを現在のポートに合わせて直すかどうかを決める。

## 2026-11-13 NX/NY の終了時書き戻しと次コマンドのパラメータ書き込みの競合を修正

ユーザーが実機で動作を確認し、キャッシュフラッシュ完了通知の修正を v0.99.4 としてリリースした。

- 提供ベンチに残っていた失敗20件の原因を確認した。前コマンドの最終フラッシュ中に CPU が次コマンドの NX/NY を書くと、その後に来る前コマンドの完了時に `reg_ny <= ff_ny` で上書きしていた。例として、HMMV の NY=1 が 0 になり、1024行描画して固まっていた。STOP 直後のパラメータ書き込みも、STOP 自身の終了時書き戻し（NY=1）で同じように壊れていた。
- コマンド開始後に CPU が書いた R#40〜R#43 をバイト単位で記録する。終了時の NY 書き戻しと Geo3D HMMV の NX/NY 復元では、記録したバイトを上書きしない。CPU が書いていない場合は従来どおり書き戻す。
- Geo3D HMMV の実行中や最終フラッシュ中に R#46（STOP、LINE の再発行など）が来ると、NX+1・NY=1 のまま残り、次の LINE の判定と描画が狂っていた。R#46 を書いた時点で元の LINE の NX/NY に戻し、Geo3D の開始判定も戻した NY で行うようにした。
- `test_vdp_command/tb_flushend.sv` に次のケースを追加した。v0.99.4 では失敗し、修正後は PASS。
  - 最終フラッシュ中のパラメータ書き込み（LINE/HMMV、前コマンドが Geo3D かどうか、STOP あり/なし）
  - Geo3D HMMV の STOP による中断と再発行
- 提供ベンチは既定条件で `bad=20` → `bad=0` (PASS)。CPU アクセスとの重なり、VRAM スロット8/32clk、NX=200 でも PASS。v0.99.4 では `ageo=1`（前コマンドが Geo3D）で524件失敗していたが、3条件とも PASS。
- `test_vdp_command`、Geo3D HMMV と画面モード、CPU・SDRAM を含むトップレベル LMCM の4ケースの回帰がすべて PASS。
- 上記修正だけで Gowin ビルドすると、配置が変わって `u_v9968/u_video_out/ff_vs` → `u_hdmi_converter/old_vs`（clk85m→clk42m）の hold が -0.042ns になった。
  - この経路は、SDC が CLKOUTD の遅れを見込んで意図的に 0.5ns の hold 余裕を要求している同期関係の経路で、除外する根拠はない。hold 補正（Correct_Hold_Violation）が有効でも残った。
  - `hdmi_converter` は clk85m の `video_vs` を `old_vs` と `meas_old_vs` の2つの FF で別々に取り込んでいた。clk42m 側の受け口を1つの FF（`vs42`）にまとめ、2つの VS エッジ検出はそこから取るようにした。VS 検出は clk42m で1クロック遅れるが、VS の立ち下がりは DE=0 の期間なので書き込み制御と行数計測に影響はない。
  - `hdmi_converter/test001` の全28ケース（シナリオ0の位相12通り＋シナリオ1〜8×分周位相2通り）が PASS。
- Gowin 1.9.12.03 の実プロジェクト設定でビットストリーム生成まで完了。setup の最小 slack は +0.075ns（`u_command/ff_command` 起点のコマンド回路内経路）、hold の最小 slack は +0.062ns で、全クロックの setup/hold TNS・違反端点は0。Logic 82%。
  - setup の余裕は前回ビルドの +0.293ns より小さい。違反ではないが、次回以降のビルドでコマンド回路の経路を注視する。
- 変更ファイル: `v9968/vdp_command.v`、`v9968/test_vdp_command/tb_flushend.sv`、`hdmi_converter/hdmi_converter.v`、`history.md`。
- ユーザーが v0.99.5 としてコミットした（ca97145）。

### 次回の作業

- v0.99.5 を実機でさらに確認する（起動ロゴ、SCREEN5〜8 の表示、VDP コマンドを多用するソフト、HDMI 出力の安定性）。
- hesoten さんの報告（`hra_report`）に残っている項目があれば、順に再現確認から進める。
- setup の余裕の改善は、事前には行わない。次に RTL を修正してビルドしたとき、その時点の最悪経路に合わせて対処する。
  - v0.99.5 の最悪経路は、LRMM のウィンドウ判定（`c_state_lrmm_wait_source`、`ff_command` → `ff_source`、+0.075ns）。
  - 対策案：判定結果を1クロック前に FF に入れる。SX/SY は VRAM 読み出しを待っている間は変わらないので、動作は変わらない。

## 2026-11-13 キャッシュフラッシュ完了通知の競合を修正

ユーザーが軽い実機動作確認で異常がないことを確認し、前日の7件の修正を v0.99.3 としてリリースした。

- 提供資料の `B01_stale_cache_flush_end` を v0.99.3 で再現。前コマンドの最終フラッシュ中に R#46 で次コマンドを開始すると、遅れた完了通知が次コマンドの CE を落とし、NY と Geo3D の状態を書き換えていた。
- `w_command_flush_end` を追加し、終了待ち状態 `c_state_finish` かつ `ff_start=0` の場合だけ CE、NY、Geo3D のフラグ・NX・コマンド種別を更新する。共有キャッシュの書き戻しは中断しない。
- BD とコマンド終了割り込みは従来の処理を維持する。前コマンドの本当の完了と次コマンドの開始が同時になる場合も、前コマンドの終了割り込みを残す。
- `test_vdp_command/tb_flushend.sv` を追加し、既存の `run.bat` に統合。実際の共有キャッシュとスロット式 VRAM モデルで、LINE、Geo3D、HMMV/HMMM/LMMV/LMMM の複数行描画、完了と再開始の同時発生、CPU アイドルフラッシュを自己判定する。修正前は CE 早落ちで失敗、修正後は全ケース PASS。
- 提供ベンチの全タイミング走査で CE 早落ち・CE=0 のまま同一画素へアクセスし続ける症状がすべて解消。CPU 共有キャッシュアクセスとの重なり、VRAM スロット32clk・読み出し遅延3clk の追加走査も PASS。
- 提供ベンチの全体結果には別原因の失敗20件が残る。前コマンドの本当の完了が次コマンドのパラメータ書き込み後・R#46 書き込み前に来る NY 書き戻し競合（6ケース）と、STOP 直後に CE を待たずパラメータを書く競合（7ケースの画素・状態、計14件）。修正前と同じ位置・症状であることを確認し、今回の対象外として未対応。
- FG4 全10画面モード、LMCM の TR=0/1、Geo3D HMMV と画面モード切り替えの回帰が PASS。CPU・SDRAM を含むトップレベル LMCM でも通常3ケースと `F1234567`、続く最後の画素 `8` が PASS。
- Gowin 1.9.12.03 の実プロジェクト設定で合成・配置配線・ビットストリーム生成を確認。最小 slack は setup +0.226ns、hold +0.074ns、タイミング違反なし。Logic 81%、CLS 95%。
- 今回のフラッシュ修正版は実機未確認。バージョン番号の変更・コミットは行っていない。

## 2026-11-12 VDP の互換性・拡張機能の修正

hesoten さんからの指摘を確認し、次の7点を修正した。LMCM 開始時の TR については、V9958 実機での確認結果を踏まえている。

- YJK の背景と合うようにスプライトの色・透明度・表示有効を4画素遅らせ、SCREEN10〜12 でも重ねて表示する。SpriteMode3 の半透明合成は YJK の RGB を背景として使う。
- SCREEN8 の固定色スプライトでも、MSK と R#27 の左端マスクを適用した表示有効信号を使う。
- LMCM 開始時は TR の前値を保持し、TR=1 で始まった場合は、最初の S#7 読みで前の値を返してから VRAM の画素を転送する。
- スプライト衝突の Y 座標を、V58 と SVNS の値にかかわらず画面上の Y+8 に統一する。スプライト選択時の R#23 ラッチ（5S 対策）は変更しない。日本語・英語のテクニカルデータブックも更新した。
- V58=1 または Port#4 の Lock=1 では、R#25 の SPS を書き換えない。他の R#25 ビットは従来どおり書き込める。
- FG4=1 の VDP コマンドは画面モードによらず SCREEN5 相当の4bit画素・256ドット幅・高速コマンドの2画素刻みで処理する。
- SpriteMode2 で EPAL=1 のとき、アトリビュート+3 の下位4bit をパレットグループとして使う。VRAM インターリーブ時にも同バイトを保持する。CC 合成は最初に描画した画素のグループを保持し、色番号の下位4bit を OR する。

### 検証

- ModelSim: SCREEN8 の MSK=0/1 と R#27=0〜7、YJK/YAE のスプライト・画素位置・半透明、SCREEN5/6/7 のパレット出力を確認。
- SpriteMode2 の EPAL、CC 合成、SpriteMode1/3 の互換動作を確認。スプライト選択から画素出力までの統合テストで、VRAM インターリーブ有無、R#23 と SVNS=0/1、および衝突 Y 座標を確認。
- FG4 の PSET/POINT/LMMV/HMMV・OR 演算・256ドット境界を全10画面モードで確認。提供された全体 VDP ベンチでも SCREEN1/8 の FG4 と SpriteMode2 の EPAL を確認した。
- LMCM は開始時 TR=0/1 と早期 S#7 読みを確認。CPU・SDRAM を含む SCREEN5 のトップレベルでは、通常転送3ケースと LMMC 後の `F1234567`、続く最後の画素 `8` が PASS。Geo3D の既存コマンド回帰も PASS。
- `test_vdp4` とスクロールテストの左端チェックは、前回の半画素遅延修正後の出力タイミングに合わせて更新し、PASS。`test_vdp4` はコミット済み RTL でも PASS。
- Gowin 1.9.12.03 で実プロジェクト設定を使った合成・配置配線とビットストリーム生成が完了。タイミング違反はなく、最小 slack は setup +0.060ns、hold +0.074ns。Logic 81%、CLS 94%。
- 今回の V9968 RTL は実機未確認。YJK、SCREEN8 マスク、LMCM、衝突座標、FG4、SPS、EPAL と既存ソフトの回帰を実機で確認する。

提供資料の `B01_stale_cache_flush_end` は今回の7件とは別の問題として未対応。

## 2026-11-12 起動ロゴ: R#26/R#27 をラッチしない方式へ変更（未コミット）

### 方針（ユーザー提案）

- `vdp_timing_control_ssg.v`: R#26/R#27 はラッチせず、常にレジスタの値をそのまま使う。スプライト選択用の `pixel_pos_y`（R#23 を X=3FFF でラッチ。DQ2 / 5S 対策）は残す。
- `vdp_timing_control_screen_mode.v`: BG の VRAM 読み出しタイミングは R#27 によらず固定（R#27=0 と同じ）。R#27 は BG 色の出力を 0〜7 ドット遅らせて実現する（512 ドットのモードは半ドット単位）。表示範囲と MSK は遅らせない。
- `vdp_timing_control_sprite.v`: スプライトの VRAM 読み出し枠も固定にする（表示位置は変えない）。
- R#26 は次の読み出しから、R#27 はその時点の出力から効く。実機と同じく「書いた位置から効く」動きになる。
- R#27 で押し出された左端 k ドットは明示的にマスクする。H ブランキング中は遅延バッファに周辺色を詰める。

### RTL 変更

- `vdp_timing_control_ssg.v`: `c_scroll_latch_pos`（X=267）のラッチを削除し、`horizontal_offset_l/h` はレジスタを直結にした。
- `vdp_timing_control_screen_mode.v`:
  - 読み出し座標はシフトしない。YJK 用の `pixel_phase_x` だけは R#27 でシフトした X から作る。
  - 遅延バッファ `ff_bg_delay[0:13]`（sub-phase 7/15 でシフト）を追加し、`w_out_delayed = ff_bg_delay[{k,0}-1]` で出力する。
  - `w_h_blank`（X<0 または X≥264）の間は周辺色をバッファに入れる。
  - `w_r27_mask`: `w_bg_start_pos ≤ X < w_bg_start_pos+k` をマスクする（`w_bg_start_pos` は G モードで 5、テキストモードで 13）。下限を付けないと、R#27=0 のときに X=0〜4 が消える。
  - `display_color_en` に `!w_r27_mask` を入れ、R#27 の左帯でスプライトも隠れるようにした。
  - `ff_pattern_valid`: 遅延前のパターンが無効になったら周辺色に置き換える。最後の k ドットが右ボーダーへはみ出す問題の対策。
- `vdp_timing_control_sprite.v` / `vdp_timing_control.v`: スプライトへの `horizontal_offset_l` 接続を削除した。
- `vdp_color_palette.v`: スプライトのゲートを `sprite_en & screen_mode_en & ff_sprite_mask_en` に変更した。`ff_sprite_mask_en` は1ドット前の `screen_mode_en`。左側のマスク解除だけが1ドット遅れる。

### テスト

- `test_vdp_timing_control_ssg/tb.sv` を書き直した。キャプチャ5ライン（A: R#27=0、B: R#27=3、C: R#27 0→3 ライン途中、D: R#26 0→2 ライン途中、E: R#27=7）。
  - 確認項目: 読み出し位相、R#26 アドレス、左マスク、遅延、右ボーダー、`cap_en`。
  - `tb_scroll_group_alignment` / `tb_scroll_midline` とも PASS。旧 RTL や右端修正前の RTL では FAIL することも確認した。
- `run.bat` に `vlog ..\vdp_timing_control_screen_mode.v` を追加した。
- ロゴベンチ: 反映は衝突ライン+1。画素照合は 498/500（外れた2本は最後の R#26=0 書き込みで、想定どおり）。
  - 期待値モデルはまだラッチ前提のまま。既定の `apply_line` では "unexpected scroll mismatches" で fatal になる。

### 実機確認（SX-2 + V9968）

1. ラッチなし方式: 起動ロゴは期待どおり1ライン単位の櫛状になった。ただし右端にロゴの一部が見えた → `ff_pattern_valid` で修正した。
2. openMSX では R#27 の左帯でスプライトが隠れるが、V9968 では隠れなかった → `display_color_en` に `!w_r27_mask` を入れて修正した。
3. 起動ロゴは期待どおりになった。しかし BASIC（SCREEN1、`SET SCROLL 4` = R#26=1/R#27=4、MSK=0）では、スプライトの左マスクが1ドットずれていた。
   - シミュレーションでは、スプライト画素は同じ座標の BG 画素より1ドット遅れてパレットに届く。R#27=k のとき、スプライトのドット k−1 が見えてしまう。
   - 対策（案B）: パレットでスプライト用マスクの解除を1ドット遅らせた。スプライトの表示位置は変えていない。
4. 案Bの結果: BASIC（MSK=0）は期待どおりになった。しかし、起動ロゴ（MSK=1）では、スプライトで隠れるべき左端の1列が見えるようになった。

### 未解決: MSK=0 と MSK=1 でスプライト左マスクの合う位置が1ドット違う

- ユーザーの見立て: MSK=1 と MSK=0 で、スプライトの遅延（またはマスク位置）が1ドットずれている。案B前は MSK=1 に合っていて、MSK=0 に合わせたら MSK=1 がずれた。
- 調べること:
  - MSK の左マスク（`ff_left_mask_pos`、G モードで X=13 から有効）と、R#27 帯のマスク（`w_bg_start_pos`〜+k）の位置関係。MSK=1 のとき、`screen_mode_en` の立ち上がりが BG ドット 8 の出力位置とスプライトのどちらに揃っているか。
  - 起動ロゴの左端の1列が、BG のロゴなのか、隠し用スプライトの欠けなのか。隠し用スプライトの位置（X=0 付近）もシミュレーションで確認する。
  - 修正案: 1ドット遅らせる処理を R#27 帯のマスクにだけ効かせる。または、MSK のマスク位置と R#27 帯のマスク位置を同じ基準に揃える。
  - ロゴベンチ（MSK=1）と BASIC 相当の条件（MSK=0、R#27=4）の両方で、スプライトのゲートを確認するテストを追加する。

### 2026-11-12 夜: スプライト左マスクの原因と修正

- 実機確認（SCREEN5、LINE と PUT SPRITE を隣接させた）: スプライトと BG は同じ X 位置に表示されている。スプライト全体が1ドットずれているわけではない。
- 原因は MSK ではなく画面モードの違い（BASIC は SCREEN1、起動ロゴは SCREEN6）。パレットのスプライトのゲートが、混ぜる BG 画素の表示有効フラグではなく、その時点の `display_color_screen_mode_en` を使っていた。
  - 通常モード: BG ドット d は X=d+7 で混ぜるが、ゲートはドット d+1 のフラグを見ていた → 左端で1列早く開く（R#27=4 の漏れ）。
  - hires（G5/G6/T2）: BG は前半が sub7 で出るため X=d+6 で混ぜる。ゲートはそのドットのフラグと一致していた → 起動ロゴは正常（案Bで逆に1列遅れた）。
  - hires では BG がスプライトより1ドット早くパレットに届く（スプライトが BG より1ドット右）。実機での確認はまだ。
- 修正: 案Bを取り消した。`ff_display_color_delay0_en` を `ff_display_color_delay0` と同じタイミング（`screen_pos_x[2:0]==0`）で取り込み、`sprite_en & ff_display_color_delay0_en` でゲートする。
- 一時テストベンチ（コミットしていない）で、通常/hires × マスク幅 4/8 のすべてで、ゲートが混ぜる BG 画素の有効フラグと一致することを確認した。旧実装は通常モードで左端1列が漏れ、右端も1列早く閉じて FAIL する。

### 2026-11-12 夜（続き）: 512 ドットモードの BG 出力位置の修正

- 実機確認（ユーザー）: SCREEN5 では、MSK=0/1、R#27=0〜7 のどれでもスプライトのマスクが BG の左端に合う（期待どおり）。SCREEN6/7 ではずれる。マスクが 512 ドット単位で足りず、スプライトがさらに右にずれる。起動ロゴの左端1列の問題はこれが原因（SP2 は無関係）。
- 原因: パレットの BG 取り込み。512 ドットモードでは前半の半画素を sub8 で取り込み、次の sub0 で使うため、通常モードより1画素（256 ドット単位）早く出力されていた。周辺色やマスクも同じだけ早いので、BG に対してスプライトが 512 ドット単位で2ドット右に見える。
- 修正（`vdp_color_palette.v`）: 512 ドットモードのときだけ、BG 色と表示有効フラグを半画素遅らせる（段数は「続き2」で1段に修正）。スプライトのゲートも同じ有効フラグ（`w_bg_color_en`）を使う。通常モードの経路は変えていない。
- 一時テストベンチ（コミットしていない）: 通常 / G6 / G5 で、BG の列・半画素・有効フラグとスプライトのドットが揃っていることを確認し、エラー 0。修正前の RTL では、512 ドットモードで BG が1画素早く FAIL することも確認した。
- 512 ドットモードでは、周辺色を含む画面全体が 512 ドット単位で2ドット右に移る（SCREEN5 と同じ位置になる）。

### 2026-11-12 夜（続き2）: 512 ドットモードの遅延段数を 1 段に修正

- 実機確認（ユーザー）: 左端の隙間はなくなったが、SCREEN6/7 の右端にロゴが見えるようになった。
- 原因: 前回の一時テストベンチで、screen_mode の 512 ドット出力を誤ってモデル化していた。実際は左半分を X の sub15、右半分を X+1 の sub7 で出す。遅れは半画素（512 ドット単位で1ドット）だけだったので、2段遅らせると逆に1ドット遅れる。左端では BG が隠れ、右端ではスプライトの終端より BG が1ドット長く出ていた。
- 修正: 遅延を半画素1段（`ff_display_color_hires` / `ff_display_color_hires_en`）にした。
- 正しいモデルの一時テストベンチ: 通常 / G6 / G5 で、X の sub0 に BG ドット X−2 の左半分、sub8 に右半分が来ること、有効フラグも同じドットであることを確認し、エラー 0。遅延なしの RTL では、半画素早いことを検出して FAIL する。
### 2026-11-12 夜（続き3）: 512 ドットモードの右半分のマスク判定

- 実機確認（ユーザー）: 1段遅延で右端は期待どおりになったが、左端にロゴの一部が再び見えるようになった。
- 原因: screen_mode は 512 ドットモードで、ドット c の左半分を X=c の sub15、右半分を X=c+1 の sub7 で出す。ところが右半分の R#27 マスクと表示有効フラグ（MSK）を、sub7 の時点の X=c+1 で判定していた。そのためマスク境界の直前のドットでは、右半分だけがマスクされず、512 ドット単位で1ドット漏れていた。2段遅延のときに左が隠れて見えたのは、漏れた位置がスプライトの下に来ていたためで、根本原因は残っていた。
- 修正（`vdp_timing_control_screen_mode.v`）: 右半分は、sub15 で判定した R#27 マスク（`ff_dot_r27_mask`）と `ff_display_color_en` をそのまま使う。256 ドットモードは sub7 で更新しないので影響はない。パレット側の半画素1段遅延はそのまま残す。
- 実機確認（ユーザー）: 起動ロゴの左右両端とも、期待どおり表示されることを確認。
### 残作業

1. 実機で SCREEN5/6/7 のスプライトのマスク（MSK=0/1、R#27）、起動ロゴの左端、SCREEN6/7 と SCREEN5 の左右端の位置を確認する。2. 実機回帰: Space Manbow、ZANAC EX、DQ2 タイトル、SCREEN0 の水平スクロール、SCREEN10〜12 の右端、BASIC のスプライト確認。
3. ロゴベンチの期待値モデルを、ラッチなし方式（衝突ライン+1）に更新する。
4. `timing.md` を、ラッチなし方式に合わせて書き直す（現在は X=267 の組ラッチと、9節のペンディングの記述のまま）。
5. ユーザーの了承を得てからコミットする。
## 2026-11-10〜11 MSX2+ 起動ロゴの櫛状スクロールずれ調査・R#26/R#27 実効値ラッチ位置の見直し

### 現象

- MSX2+ の起動ロゴ（SX2 に差し替えたもの）は、左右から櫛状にスクロールしてきて中央で合流する。V9968 では、このスライスがランダムに横へずれる。
- ロゴ表示プログラムは、スプライトの衝突判定で走査線を検出し、ラインごとに R#26/R#27 を書き換えている。

### ロゴルーチンの解析（MSX0KDR.ROM、Z80 7A00h〜7CB4h、ファイルオフセット 3A00h〜）

- SCREEN 6、192 ライン、60Hz。スプライトは 16×16 の拡大表示で、X=232 付近で毎ライン衝突するように配置している（SAT 7600h、パターン 7800h）。
- 1 フレームで 85 回ループする。各ループの処理:
  1. R#17=26（オートインクリメント）を設定する。
  2. `IN A,(99h)` で衝突フラグをクリアする。
  3. `IN A,(99h) / AND 20h / JP Z` で衝突をポーリングする（1 周 31T）。
  4. `OUT (C),H` で R#26、`OUT (C),L` で R#27 を書く。
- 帯ごとに pair(x) と pair(512−x) を交互に書く。R#26=((x−1)>>3)+1、R#27=(−x)&7。

### テストベンチ `test_top_SCREEN6_LOGO`（新規）

- `tb.sv` は ROM ルーチンを T ステート単位で再現する（M1 ウェイト +1 込み）。WAIT 対応の I/O サイクルで V9968 カートリッジ全体を駆動する。
- 実行方法: `run.bat`、または `vsim -c -t 1ns -gfirst_frame=N -gnum_frames=M -do run.do tb`。初期化込みで1フレーム約2分。
- 出力:
  - 各ラインの x=128 で `ff_horizontal_offset_h/l` を期待値と比べ、OK / STALE / MIX_R27 / MIX_R26 / OTHER / TOO_LATE に分類する。2 重ラッチも数える。
  - 表示期間（X=0〜255）中に実効値が変化したら MIDLINE として数える。
  - R#26/R#27 の書き込み位置（衝突ライン+1 基準の X）の範囲を出す。
  - 期待する反映ラインは `-gapply_line=N`（既定 2、衝突ライン+2）。最後の帯は直後の R#26=0/R#27=0 で上書きされるため判定しない。
  - 詳細は `logo_lines.csv` に出す（git 管理外にするかは未定）。

### 経緯

1. 修正前（R#26/R#27 を X=R#27−1 で同時ラッチ）: frame0〜5、CPU 位相0で 510 ライン中 OK=486、STALE=13、MIX_R27=10、OTHER=1（期待値は衝突ライン+1）。
2. R#27 が自分のラッチ位置を過ぎてから書かれたら、書き込み時点で R#26/R#27 を組で即時ラッチする補正を入れた。ベンチでは衝突ライン+1 で 510/510 OK になった。
   - しかし実機では悪化した。最初は揃うが、中央に集まるあたりで 8 ドット単位でない大きなずれが出た。
   - 「過ぎた」の判定に上限がなく、表示期間中の書き込みでも即時に切り替わる。V9958 が状況に応じて反映位置を変えるとは考えにくいため、取り下げた。
   - 実機の動画では、ロゴ最上段のスクロール方向が本物の V9958 と逆だった。隣り合うラインは pair(x) と pair(512−x) を交互に使うため、反映が1ライン違うと逆向きに見える。本物は衝突ライン+2 で反映していると考えられる。
3. 方針: 実効レジスタへのコピーは、R#27 の値や書き込みタイミングによらない固定位置で行う。8 ドット周期処理の開始前に、R#26/R#27 を組で更新する。

### 書き込み位置の測定（ロゴベンチ）

- 衝突はほぼ毎ラインあり、ポーリング周期 31T のため書き込み位置がばらつく。
- 衝突ライン+1 基準で R#26 は X=−60〜−14（前ラインの X≈282 から）、R#27 は X=−39〜+7。frame0〜2、40〜42 で同じだった。
- この範囲（約 67 ドット）の中にコピー位置があると、組が崩れる。範囲の外で表示開始前に置けるのは、前ラインの表示終了後 X≈256〜281 だけ。

### 現在の RTL（OCM-PLD 準拠タイミング）

- `vdp_timing_control_ssg.v`:
  - R#27 は X=−16 の固定位置でラッチする（OCM のプリドットカウンタ初期値ロード位置）。
  - R#26 は X=−9+R#27（ラッチ済み R#27）でラッチする（OCM の内部 HSYNC）。
- R#26/R#27 は表示開始前にラッチされ、表示中は変化しない。R#18 の水平補正は従来どおり `vdp_upscan.v` で直接参照しており、ラッチしていない。
- `tb_scroll_group_alignment` の期待値を新しいラッチ位置（R#27: `14'h3EFF`、R#26: `X=R#27−10` の最終サブフェーズ）に更新した。`tb_scroll_midline` はそのまま PASS。

### 検証結果

- ロゴベンチ（期待値: 衝突ライン+2、CPU 位相0）:
  - OCM 準拠: frame0〜2、40〜42 とも OK=0。R#26 は常に衝突ライン+1、R#27 は書き込み位置により +1/+2 に分かれ、R#27 が異なるフレームでは半数のラインが MIX_R26 になる。MIDLINE=0。
  - 比較実験（コミットしていない）: R#26/R#27 を組で前ラインの X=264（HSYNC 開始、`c_hsync_start`）にラッチ。6フレームとも最後の帯以外の 84/84 ラインが OK、MIDLINE=0。
- 注意: ベンチの CPU タイミングは逆アセンブルからの推定。衝突検出タイミングが本物の V9958 とずれていれば、書き込み位置も変わる。
- 実機（2026-11-11 朝）: OCM 準拠の現在の RTL でも、起動ロゴはまだ乱れる。ベンチの結果（組が崩れる）と矛盾しない。

### 残作業（帰宅後）

- 前ライン HSYNC 開始位置（X=264、`c_hsync_start`）で R#26/R#27 を組でラッチする案を実装する。
  - 比較実験では R#27 を `w_screen_pos_x == { 10'd263, 4'hF }` でラッチし、R#26 も同じ位置でラッチした。
  - `tb_scroll_group_alignment` / `tb_scroll_midline` の期待値を新しいラッチ位置に合わせて更新する。
  - ロゴベンチで frame0〜2、40〜42 に加え、CPU 位相 6/12/18 も確認する。その後、実機で起動ロゴを確認する。
- R#18 の水平補正も、R#26/R#27 と同じ位置でラッチするか検討する（現在は `vdp_upscan.v` で直接参照）。
- 本物の V9958 で、R#26/R#27/R#18 がどこで実効値にコピーされるかを測定するプログラムを作る（走査線割り込み後の待ち時間を 1T ずつ変えて書き込み、反映ラインが切り替わる点を探す）。
- 作業中の状態: `vdp_timing_control_ssg.v` と `test_vdp_timing_control_ssg/tb.sv` は OCM 準拠のまま未コミット。`test_top_SCREEN6_LOGO/` は未追跡。ロゴベンチの `apply_line` 既定値は 2。

### 2026-11-11 夜: 固定位置 X=267 で R#26/R#27 を組でラッチ

- OCM 準拠の状態は GitHub に push 済み（いつでも戻せる）。
- タイミング設計を `v9968/timing.md` にまとめた。
  - 8ドット組は R#27 分シフトしているので、最後の組は X=255+R#27（最大262）まで続く。R#27 を参照する最後のイベントは `start_info_collect`（最大 X=266/14）。
  - そのため X=256 ではなく、シフト基準の処理がすべて終わった直後の X=267（`{10'd266, 4'hF}` で比較）を固定のラッチ位置とした。
  - info_collect はラッチ位置をまたぐが、sub-phase だけで動くので R#27 の影響を受けない。終了は次ラインの X≤−28 で、リフレッシュ (X=−16) より前。
- ユーザー補足: SCREEN0 では R#26 は無効で、R#27 の 0〜7 ドットのみ。SCREEN10/11/12 で画面全体が4画素ずれるのは V9958 の仕様。
- 変更:
  - `vdp_timing_control_ssg.v`: R#26/R#27 を `c_scroll_latch_pos`（X=266/F）で同時にラッチする。
  - `test_vdp_timing_control_ssg/tb.sv`: 期待値を `14'h10AF` に変更し、2つのテストとも PASS。
  - ロゴベンチ: 期待値モデルを X=267 の組ラッチに変更。
- 結果: ロゴベンチは 6フレームとも 84/84 OK（frame0〜2 の実行で OK=252、frame40〜42 の実行で OK=252、合計 504/504）、MIDLINE=0、DOUBLE_LATCH=0。
- 次: 実機で起動ロゴ、Space Manbow（ラスタスクロール境界の1ラインずれ）、ZANAC EX を確認する。
- 補足: `test_vdp_timing_control_ssg` の `tb` トップはポート定義が古く、ロードエラーになる（今回の変更とは無関係）。

### 2026-11-11 夜（続き）: 実機確認と画素照合

- 実機（SX-2 + V9968、CPU 3.58MHz、V9968 は独立発振）: 大幅に改善した。後半は綺麗な櫛状になったが、前半（高速移動中）は2ラインがまとまって動く箇所が目に見える。本物の MSX2+（FS-A1WSX など）は最初から最後まで1ライン単位。
- FS-A1WSX の BIOS（openMSX 用 `fs-a1wsx_kanjibasic.rom`）は MSX0KDR.ROM と完全一致した。ベンチの CPU 手順は正しい。
- ロゴベンチ frame3〜39: レジスタ判定はすべて 84/84 OK、MIDLINE=0。書き込み位置は毎フレーム同じで、R#26 は前ライン X=282〜−14、R#27 は −39〜+7。R#26 の最早書き込みとラッチ位置（267）の差は約15ドット（約10T）しかない。
- ロゴベンチに画素照合を追加した:
  - VRAM の page0/1（各212ライン）に乱数をバックドアで書き込む（SDRAM モデル `Bank0` に直接書く）。
  - 各ラインの X=24〜231 の BG 出力（`ff_display_color[1:0]`、hires 416画素）を取り込む。
  - 取り込んだ画素が VRAM の 1024画素リングのどこから読まれたかを探し、2×スクロール量との差（パイプライン定数）が全ラインで一定か確かめる。
- 結果: frame0〜21 の全ライン（計約4800ライン）で一致した（NG=0、NO_MATCH=0、定数=36）。同期した CPU タイミングでは、BG 描画側も正しい。
- 残る候補:
  - SX-2 の Z80 の M1/I/O ウェイトが実 Z80 と違い、書き込みが早まって R#26 が前ラインのラッチ位置（267）より前に入る（余裕は約10T）。その場合、R#26 だけが1ライン早く反映される。CPU と VDP の位相が独立していることも影響する。
  - HDMI 経路（upscan のラインバッファ、ダブルバッファ）。
- 対策の候補: 2段ラッチ。表示期間中の固定位置（S≈144）でサンプリングし、X=267 で実効レジスタにコピーする。
- ユーザー情報: SX-2 の CPU クロックは 50MHz から PLL で作っており、3.579545MHz ちょうどではない。V9968 は 28.63636MHz の8分周なので正確。このずれ分の影響がある。
- **ペンディング**: 表示はかなり綺麗になり、実害も小さいため、いったん保留とする。CPU も 3.579545MHz で動く FPGA MSXtR が届いたら再確認する。
- `timing.md` に「9. 現状（ペンディング）」の節を追加した。
- ここまでの変更（X=267 の組ラッチ、SSG 単体テスト、ロゴベンチの画素照合、timing.md、history.md）は GitHub に push 済み。

### 次回以降の作業

1. 実機で Space Manbow（ラスタスクロール境界の1ラインずれ）と ZANAC EX（R#23 系の回帰）を確認する。
2. FPGA MSXtR（CPU 3.579545MHz）が届いたら、起動ロゴを再確認する。2ラインがまとまる現象が残るなら、次を検討する。
   - ロゴベンチで CPU タイミングを揺らして再現させる（M1 ウェイトの有無、CPU/VDP の位相・周波数のずれ）。
   - 2段ラッチ（S≈144 で取り込み、X=267 で実効レジスタにコピー）。
3. 未解決の小物: `test_vdp_timing_control_ssg` の `tb` トップのポート定義が古い。ロゴベンチの `logo_lines.csv` やログ類を git 管理外にするかどうか。

## 2026-11-08 DQ2 タイトルのロゴ欠け修正・R#23 ラッチ・走査線割り込みフラグの退行修正（v0.98 / v0.99）

### Dragon Quest II（MSX2）タイトル画面のロゴ欠け

- 現象: ロゴのスクロールが止まり盾と重なると、ロゴ中央（スプライト）が消える。
- 調査: ROM の逆アセンブルとダンプ用 ROM で解析した。YMMM 転送とキャッシュは正常だった。ゲームの VSYNC 割り込み処理が S#0 の 5S を検出すると、0x7600〜0x767F（停止後のスプライトアトリビュート）を毎フレーム `E0 00 00 00` で上書きしていた。
- 原因: F=1（VSYNC 割り込み中）でも S#0 bit6 の 5S が 1 として読めていた。
- 修正（`vdp_cpu_interface.v`）: S#0 bit6 を `5S AND NOT F` とした。全スプライトモードで適用する。読み出し時の 5S クリアは従来どおり。OCM-PLD でも 2017 年頃に同様の修正（yuukun 氏）が入っている。
- 確認: `test_vdp_cpu_interface` の `tb_sprite_overmap_status` を更新して PASS。実機で電源を3回入れ直し、毎回正常表示を確認した。
- 注意: OCM-PLD はスプライトモード1 を対象外にしている（ZANAC A.I. 対策）。V9968 はモード1 も対象としている。

### スプライト処理の R#23 ラッチ

- R#23 は即時反映のため、ライン途中で書き換えられると、1ライン分の走査を前提とするスプライト処理で前後のラインの結果が混ざる。
- `vdp_sprite_select_visible_planes.v`: ライン開始（`screen_pos_x == 3FFF`）で Y 座標（R#23 込み、R#23 非参照モードでは `screen_pos_y`）をラッチし、選択・5S 判定・パターン行番号に使う。
- 衝突座標 Y（S#5/S#6）もこのラッチ値を使うよう変更した（`vdp_sprite_makeup_pixel.v`、`vdp_timing_control_sprite.v`）。R#23 非参照モードにも従う。
- `test_vdp_sprite_select_visible_planes` にテスト10（走査途中の R#23 変更）とテスト11（非参照モード）を追加し、全テスト PASS。

### ZANAC EX・Space Manbow の表示崩れ（v0.96 からの退行）

- 現象: ZANAC EX はタイトルが激しくチラつき裏画面が見え、ゲーム中のスコアがほぼ見えない。Space Manbow は KONAMI ロゴとタイトルが下にずれ、ゴミが出る。
- 切り分け: GOWIN Programmer で各版を書き込み、v0.93 正常、v0.96 異常を確認した。コミットごとのビルド済み `.fs` で、76991af 正常、a849a2c 異常と特定した。なお V9968UpdWin では書き込みに失敗する場合があり、当初の切り分けを誤った。
- 原因: a849a2c で走査線割り込みフラグ FH のクリア条件が「IE1=0 を書いた R#0 書き込み」のみに狭められていた。FH は IE1=0 でも立つため次フレームへ持ち越され、ゲームが IE1=1 にした瞬間に割り込みが入っていた。
- 修正（`vdp_cpu_interface.v`）: v0.93 と同じく、VSYNC（`clear_line_interrupt` / `intr_frame`）と R#0/R#19 書き込みで FH をクリアするよう戻した。a849a2c のキャッシュデッドロック対策（`vdp_vram_interface.v`）は残している。
- 確認: 実機で ZANAC EX・Space Manbow の正常動作を確認し、v0.99 としてリリースした。

## 2026-11-07 スプライト CC=1 の Sprite#0 が表示される問題の修正

### 現象

- AshGuine Story III（Microcabin）のデモで、ゴミのようなスプライトが表示された。CC=1 の Sprite#0 が表示されていた。

### 原因

- `vdp_sprite_makeup_pixel.v` では、plane N を phase N で選択し、その情報が `ff_color_*` に届くのは phase N+4 である。
- ところが、合成の初期化（最初のプレーンの処理）と、合成結果のラッチを phase 3 で行っていた。
- そのため phase 3 で、前のスロットの plane15、または使っていないプレーン枠に残っている CC=0 のデータを拾っていた。合成部はこれを「CC=0 のプレーンが先にあった」と誤判定するので、続く Sprite#0 が CC=1 でも表示されていた。
- 同じ原因で、16枚表示時の plane15 が1画素右にずれていた。

### 修正内容

- 合成の初期化と結果のラッチを phase 4 に変更した。
- 衝突判定で除外する phase を 1 から 4 に変更した。phase 4 では合成状態がまだ前の画素の結果のため、判定から外す。これにより、plane13 が関わる衝突も検出するようになった。
- 表示の水平位置（パイプライン遅延）は変わらない。

### 確認

- 単体ベンチ9ケースを修正前と修正後の RTL で実行した。対象は CC=1 単独、CC の OR 合成、優先順位、衝突、plane7/plane15、16枚中 plane0 が CC=1 の場合など。修正前は4ケースが FAIL、修正後は全ケース PASS。
- 既存の `test_vdp_timing_control` も PASS した。
- 実機でデモのゴミが表示されなくなったことを確認した。

## 2026-11-06 LMCM 実機テストの不一致の調査

- 2画素目以降が誤る原因は RTL ではなく、テストプログラムにあった。`write_params` が R#44 を書いた後に A を 0 に戻さず R#45 を書いていたため、R#45 に ACh が入り、DIX/DIY=1（X/Y とも減少方向）になっていた。
- `test\` の LMCM 系テスト（LMCM2/2V/3、LMCMPRB/PRB2、LMCMCHK）で R#45 に 0 を書くよう修正した。COM も再ビルドした。
- LMCM2V では次の2点も修正した。
  - P=2（最初の S#7 読み出し）の値を記録するようにした。
  - CASE9（SX=254, NX=4）は X のオーバーフローで2画素目の後に終了するため、期待値を2画素にした。
- 診断プログラム `test\LMCMDIAG.ASM/.COM` を追加した。各行に、読んだ位置が分かる値を書き込んでおく方式。
- 実機で LMCMDIAG と LMCM2V が全ケース OK になった。RTL は変更していない。
- アセンブルにはリポジトリ内の `tool\zma.exe`（v1.0.20）を使う。古い v1.0.15 ではアセンブルできない。

## 2026-11-01 Geo3D の HMMV 高速化・SCREEN10/11 パレット修正・Geo3D ホールド違反対策

### Geo3D 塗りつぶしの HMMV 高速化

- issue #9 の提案に基づき、Geo3D の通常塗りつぶし行（LOP=0 の水平1行）にタグ（fill_span）を付けて VDP に渡し、VDP 側で1行の HMMV として高速に描画するようにした。
- 対象は SCREEN8 のみ。`c_g7` は SCREEN8/10/11/12 を含むため、`ff_screen_mode[c_g7] && !reg_yjk_mode` で判定する。それ以外のモードや論理演算付きの場合は従来の LINE で描画する。
- 変更: `geo3d_engine.v`、`geo3d_bus.v`、`geo3d/readme.md`、`tangnano20k_vdp_cartridge.v`、`vdp.v`、`vdp_command.v`。既存テストベンチ（test_vdp、test_vdp2、test_vdp3、test_vdp_SCREEN0）に `ext_cmd_*` の未使用接続を追加した。
- `geo3d/test_hmmv`（`tb.sv`、`tb_vdp_modes.sv`、`run.bat`）を追加し、各モード・LOP・画面外・テクスチャ混在・ワイヤーフレーム・モード切替時の動作を確認した。実機で明らかに高速化したことを確認済み。

### SCREEN10/11 (YJK+YAE) で A=1 のパレット画素が黒くなる問題

- 原因は `vdp_color_palette.v` の3点。
  1. A=1 の画素でパレット RAM を読んでいなかった。
  2. YJK モードでも SCREEN8 用の色（YJK モードでは更新されず 0 のまま）を選択していた。
  3. パレット側の参照画素（delay3）が、YJK の A 判定に使う画素（delay4）と1画素ずれていた。
- A=1 では画素の上位4bit をパレット番号としてパレット RAM を読み、その RGB を出力するよう修正した。A=0 は従来どおり YJK 変換。SCREEN12・SCREEN8・拡張パレットモードの経路は変更していない。
- 単体シミュレーションで、パレット0〜15、A=1/A=0 交互画素の位置合わせ、SCREEN10/11 の A=0・SCREEN12・SCREEN5・SCREEN8 を確認した。実機では未検証。
- 既知の未対応事項: SCREEN10/11 の A=0 画素と SCREEN12 では YJK 色がスプライトより優先される（既存動作）。

### Geo3D の clk85m → clk42m ホールド違反対策

- clk42m の立ち上がりは clk85m の立ち上がりと一致するため、立ち上がり同士の受け渡しはホールド関係が 0ns となり、SDC のホールド不確かさ 0.5ns より短い配線（`a_data → texy` 0.480ns など）で違反していた。データが速く着きすぎることが原因のため、FF 複製による負荷分散は逆効果と判断した。
- `geo3d_bus.v` で、`req_t`/`a_sel`/`a_wr`/`a_data` を clk85m の立ち下がりで取り直すコピー FF（`syn_preserve` 指定）を追加した。エンジン側では req 検出時に `e_wr`/`e_rd` と同時に `e_sel`/`e_din` へ取り込み、エンジンへ渡す。受け渡しは立ち下がり→立ち上がりの FF 1段となり、ホールドに半周期の余裕ができる。req 検出の clk42m エッジ、ack、busy の動作サイクルは変わらない。
- 立ち下がりのコピーをエンジンへ直結する案は、エンジン内部の深いロジックのためセットアップが -5.2ns となり不採用。SDC の `set_false_path` による除外も修正ではないため採用していない（SDC は変更なし）。
- `test_hmmv` の2本は PASS。別ディレクトリでの全体合成・配置配線で setup/hold 違反0件、最小 slack は setup +0.103ns、hold +0.074ns。新しい受け渡しのセットアップは +3.934ns。Register 8975 → 8995。
- 途中の配置では Geo3D 外の `ff_vs → hdmi_converter`（clk85m → clk42m）が -0.035ns になったことがある。再発した場合は同様の方法で対策できる。実機では未検証。

## 2026-11-01 VRAM 読み出しの先読みと WAIT

- 99h/89h で読み出しアドレスを設定した時点と、98h/88h から読み出した後に、次の VRAM データを先読みする。98h/88h への書き込み値も読み出しバッファに反映し、アドレスは次のアクセス先を指す。
- 先読みや VRAM 書き込みが終わる前の次の VDP アクセスを保持する。VDP の 88h-8Ch または 98h-9Ch では処理完了まで WAIT を出し、読み出しデータは WAIT 解除前に2クロック保持する。System Controller や Geo3D には WAIT を追加しない。
- ポートオフセット6は MegaRAM 用に予約されているため、VDP からの応答を停止してバスを解放する。
- `test_vram_prefetch_wait` を追加し、リフレッシュによる遅延、連続読み書き、キャッシュ退避、他ポートとの分離、14/17/18bit のアドレスラップ、読み出し待機中のリセットを確認した。先読み済み読み出しの応答は RTL シミュレーション上で最大約110ns。System Controller のポート分離、共有キャッシュ、VDP のレジスタ・ステータス関連テストも通過した。
- Gowin の検証では、従来の `Map_Option=3` で setup 違反58件、hold 違反6件だったため、プロジェクト設定を `Map_Option=1` に変更した。プロジェクト設定を用いた別ディレクトリでの再合成・配置配線は setup/hold 違反ともに0件、Logic 16545/20736、LUT 13941、ALU 2484。最小 slack は setup +0.092ns、hold +0.047ns と余裕が小さい。
- 実機では未検証。MSX スロットの外部遅延制約はなく、R800 の WAIT サンプリングを含む基板上のタイミングは別途実機で確認する必要がある。

## 2026-10-24 SPI クロック調整・Windows USB 更新ツール作成

### 本線への合流と SPI クロック

- HDMI 対応を本線へ合流したため、以後は `fpga/V9968_Cartridge_TangNano20K` で開発する。
- HDMI 対応に伴い `clk_serial` が約143.18MHzになった状態で、SPI クロックが従来の8分周で約17.9MHzになっていることを確認。`spi_rom/ip_spi_rom.v` の分周を6分周へ変更し、約23.86MHzとした。連続転送時の High/Low はそれぞれ入力クロック3周期で、デューティー比50%を維持する。
- System Controller の test003 を更新し、最短半周期20952psと既存の書き込み・読み出し動作をシミュレーションで確認。関連仕様書と MSX 更新ツールの説明を更新した。
- ユーザー側で合成パラメータを調整し、タイミング違反のない結果を取得。Rev.2の2枚とRev.3の1枚で `V9968UPD.COM` による書き込みと、更新後の起動に成功した。

### V9968UPD for Windows

- `tool_for_windows` に C# / WinForms / .NET Framework 4.7.2 の USB 更新ツールを作成。Visual Studio 2022 のソリューション、ソース、`build.bat`、ビルド済み `V9968UpdWin.exe` と使い方を配置した。
- 「更新ファイル選択 → USB 接続確認 → 書込み」のウィザード形式とした。パス直接入力・参照ダイアログ・ドラッグ＆ドロップに対応し、ファイルのシグネチャ32byte全体と本体サイズ1-7D0000h byteを検査する。
- GOWIN Programmer CLI を保存済みパス・PATH・一般的なインストール先から検索し、見つからない場合は指定ダイアログを表示。接続画面からの CLI 変更にも対応した。利用には GOWIN Programmer と対応ドライバーのインストールが必要。
- `V9968CFG.BIN` の先頭48byte（シグネチャ32byte＋バージョン16byte）は Flash に書かず、除去した本体だけを一時的な `config.bin` として CLI に渡す。本体が元の `tangnano20k_vdp_cartridge.bin` と完全一致することを確認した。元の `.fs` のビット列および CLI の形式変換結果も、この `.bin` と一致した。
- 最初は通常方式の `--run 32` を使用したが、実機では `SPI end of address: 0x-00100`、`Error: Error found!`、終了コード254で失敗した。GUI で成功している操作が36（GAO-Bridge経由）であることを確認し、本体・バージョン領域の書き込みを39へ変更した。失敗の内部原因までは特定していない。
- 成功した本体書き込みのコマンドは次の通り。`config.bin` はヘッダ除去済みの一時ファイルであり、更新ファイルそのものではない。

  ```text
  programmer_cli --device GW2AR-18C --frequency 2.5MHz --run 39 --fsFile "<config.binのパス>" --spiaddr 0x000000
  ```

- 操作39は `exFlash C Bin Erase,Program,Verify thru GAO-Bridge`。本体の成功後だけ、全FFhの64KB内のオフセットFF00hにバージョン16byteを置いた `version.bin` を、同じ操作で7D0000hから書き込む。これにより7DFF00hへバージョン情報を記録する。本体失敗時はバージョン更新に進まない。最後に操作1（Reprogram）で再起動を試み、失敗時はUSBの抜き差しを案内する。
- CLI 出力から工程と進捗率を読み取り、本体0-88%、バージョン情報88-97%、再起動97-100%の単一バーで表示する。進捗率が出力されない間は時間ベースの推定値を使用する。工程名は実行中の処理で管理し、本体の失敗をバージョン情報の失敗と誤表示しないよう修正した。
- 失敗時は工程別エラー、CLI 出力、終了コードと実行コマンドをログへ表示。復旧方法は GUI の操作36で元の `.fs` を書き込む手順を案内した。
- 現在の ConfigROM バージョンの読み出しは実装しておらず、その表示欄を削除した。「書き込むバージョン」を表示し、正常終了後だけ「書き込んだバージョン」に切り替える。これは書き込み結果の表示であり、起動前の Flash 内容を読み出したものではない。

### 検証・完了

- ヘッダ除去後のデータ一致、バージョンブロック生成、入力エラー、サイズ上下限、CLI の検索と未接続時の検出を確認した。
- 操作39への変更後、ユーザーが実機で書き込み成功を確認。表示の整理後も使いやすい更新ツールになったとの確認を得た。
- 最終版は Visual Studio 2022 の MSBuild で Release ビルド成功、警告・エラーなし。`tool_for_windows/V9968UpdWin.exe` を更新済み。作業をいったん終了する。

## 2026-10-23 ConfigROM Reader/Writer 組み込み・V9968UPD 作成（朝の作業）

### System Controller / SPI Flash

- Y8960 Cartridge からコピーした `spi_rom/ip_spi_rom.v` と `system_controller/system_controller.v` を V9968 Cartridge に組み込んだ。System Controller のデバイス ID は 01h、ファンクション 01h は Config ROM Reader/Writer とする。
- V9968 Cartridge には SerialSRAM がないため、コピー元の起動時 ROM→SRAM コピーと、そのための初期化・WAIT 制御を削除した。既存の SDRAM 初期化中の WAIT 制御は維持する。
- `msx_slot.v` に I/O 40h-4Fh のデコードと System Controller 用のアドレス・選択出力を追加。既存の 88h/98h の VDP/geo3d 用デコードを維持し、トップで読み出し応答を取りまとめた。
- コマンド実行中は System Controller への読み書きを無視し、WAIT や完了後の再実行は行わない。MSX 側はコマンド発行後、40h が 7Fh を返すまでポーリングする。VDP/geo3d の既存ポートは利用可能。
- トップに `mspi_cs` / `mspi_clk` / `mspi_hold` / `mspi_wp` / `mspi_do` / `mspi_di` を追加。添付回路図に合わせて BANK3 の 60 / 59 / 63 / 57 / 62 / 61 番ピンへ割り当て、Gowin の「Use MSPI as Regular IO」を有効化した。
- System Controller と SPI のバスクロックは `clk85m`、SPI のシリアル側は `clk215m` を使用。シリアル側のリセット解除を同期化し、要求/応答ハンドシェイク用のクロック間制約を追加した。
- Gowin プロジェクトへ RTL を登録し、`doc/spec/system_controller.md` の ID 記述と接続・動作仕様を更新した。

### V9968UPD

- `tool` にコピーされた Y8960 更新ツールを `v9968upd.asm` / `V9968UPD.COM` に改名・変更し、ZMA でビルドできる ConfigROM 専用ツールを作成した。
- `/C`・`/B` と BIOS 更新・BIOS バージョン処理を削除。`V9968UPD V9968CFG.BIN` で更新し、引数なしでは Usage と検出したカートリッジの Config バージョンを表示、`/H`・`/?` ではヘルプを表示する。
- System Controller の ID は 01h を選択。イメージ先頭の `V9968_TN20K_CARTRIDGE` と 00h パディングを含む 32byte 全体を検査し、続く 16byte をバージョン情報、+48 以降を Config data 本体として扱う。
- Config data は 000000h から書き込み、サイズは 1-7D0000h byte に制限。消去時の BUSY 観測・先頭 256byte の簡易ブランクチェック、書き込み後の全データのベリファイ、エラー時のアドレス・期待値・実読値・直前の SR1 表示を引き継いだ。
- 本体の書き込み・ベリファイが成功した後だけ、専用の 64KB ブロック 7D0000h-7DFFFFh を消去し、7DFF00h-7DFF0Fh に 16byte の Config バージョンを書き込んで検証する。本体更新失敗時はバージョン領域を更新しない。
- `build.bat` と `tool/v9968upd.md` を更新。`config/header.bin` と `V9968CFG.BIN` のヘッダ・データ本体の整合も確認した。

### 検証結果

- ModelSim の System Controller テスト 3 本と各 `run.bat` がすべて成功（エラー0、警告0）。ID/Function 選択、BUSY 中のアクセス無視、スロットデコード・バス解放、Flash の読み書き・64KB 消去・チップ消去・ステータス読み出し・40h ポーリングを確認した。
- Gowin の合成・配置配線・ビットストリーム生成が成功。最終検証ビルドは Setup/Hold 違反とも0件。解析上の Fmax は `clk215m` が 217.926MHz（要求 214.773MHz）、`clk85m` が 86.029MHz（要求 85.909MHz）。変更前の比較ビルドも Setup/Hold 違反0件だった。85MHz 側の余裕は小さい。
- ZMA で `V9968UPD.COM`（2326byte）を生成。Python の `test_v9968upd.py` で COM 自体を Z80 エミュレータ上で実行し、8 テストすべて成功。引数・検出・シグネチャ・サイズ、消去/書き込み/検証異常時のバージョン保持、16KB/64KB 境界などを確認した。MSX-DOS と System Controller はテスト用モデルを使用。
- ユーザー側でも合成が通り、FPGA へ書き込めるところまで確認済み。MSX に装着しての `V9968UPD` による ConfigROM 更新はまだ未確認。

### 次回（帰宅後）の確認

- 実機 MSX に装着し、引数なしの `V9968UPD` でデバイス検出と Config バージョン表示を確認する。
- `V9968UPD V9968CFG.BIN` で消去・書き込み・ベリファイ・バージョン更新まで成功するか確認する。
- 更新後のバージョン表示と、再起動後に更新した FPGA コンフィグレーションで起動できることを確認する。更新失敗時は表示されたアドレス・期待値・実読値・SR1 を記録する。

## 2026-09-30 VDPコマンド互換性とタイミング改善

### コマンド互換性

- `ds4.rom`のデモ停止調査で、DIY逆走査時にコピー元SYが先にY=0へ到達しても、LMMM/HMMM/YMMMがコピー先DY側の境界しか終了条件に含めていないことを確認。コピー元・コピー先のうち先に上端へ到達する側で行を打ち切るよう`w_sy_overflow`を追加した。256KB VRAM時は既存の11bit Y座標を使い、Y=0を上端とする。
- [Issue #10](https://github.com/hra1129/V9968_Cartridge/issues/10)のSCREEN2（R#25 CMD=1）でHMMM/HMMV/YMMM/HMMCが1バイトおきに処理する問題を修正。非ビットマップモードをbyte単位として扱い、`w_next`と`w_nx_max`の刻み幅・終端値を一致させた。FG4のSCREEN5相当動作とSCREEN5/6/7/8の従来刻み幅は維持する。

### タイミング改善

- PnRレポートでclk85mのSetup違反16 endpoint、TNS -4.906 ns、最悪slack -0.459 nsを確認。最悪パスは`ff_fg4`から`w_next`、`w_next_sx`を経て`ff_xsel`のCEに至っていた。
- R#46書込み時に1/2/4のpixel stepを`ff_pixel_step`へ登録し、実行中の座標更新とNX終端判定で再利用するよう変更。FG4判定を画素処理の組合せ経路から外した。
- ModelSimで`vdp_command.v`単体コンパイルはエラー0、警告0。ユーザーがGowinビルド後にタイミング違反の解消を確認した。改修後の機能全体回帰は未実施。

## 2026-09-29 Fleet Commander II 起動停止の調査・ポート#1ラッチ修正

### 症状

- 実機MSX（内蔵VDP無効化）にV9968カートリッジを装着し、別スロットのASCII8Kメガロム「Fleet Commander II」を起動すると、212ライン化→画面一面シアンの後、黒画面になる前に停止した。本物のVDPでは正常起動する。

### 調査

- ROM(ASCII8K)の起動経路を逆アセンブルで追跡。H.STKE経由でバンク0 `405Eh` → `CHGMOD 7`、ページ1への64KB `BIGFIL` → RAM `D011h`（スロット走査・FM音源検出・H.TIMI設定） → バンク28 `4BE0h` → バンク29 `41EBh` → `4745h` で画面初期化。シアンは `6461h` の表示OFF（R#7=7の周辺色）。
- 停止地点の切り分けのため、指定地点で `DI`→R#7に目印色→`JR $` を実行するパッチROMを作成。バンク29 `41EBh`（赤）は到達、バンク2 `62FFh`（緑）は未到達で、停止箇所をバンク2 `6372h` 内に特定。
- `6372h` はポート99hへ `00,22,81,0F,86,00,88` の奇数バイトを書き込み、組がずれる。本物のV9938/V9958はポート98hの読み書きや、いずれかのポートの読み出しで99hの1バイト目の保持を取り消すため、直後の `CLRSPR` の98h書き込みで組が復帰する。V9968は99h書き込みでしか組の状態が変わらず、以降のレジスタ書き込みがずれ続け、CE待ちから抜けられなくなっていた（誤ったR#46書き込みで転送待ちコマンドが起動したと推定）。
- ゲーム内のステータス読み出し（99h read）は、CE待ち（S#2 bit0）、HMMC/LMMCループ（S#2 bit0/bit7）、POINT（S#7）のみ。S#0のF、S#1、S#2のHR/VRでの分岐はなく、ステータス値の差異は原因ではなかった。
- 実機で `SCREEN 7`→表示OFF→R#8=0→`CLRSPR`→`CLS`→`SCREEN 5` を99hへ必ず2バイトずつ書くBASICで再現したが停止しなかった。奇数バイト書き込みが再現条件。

### openMSXの挙動（`VDP.cc` の `writeIO`/`readIO`）

- 98h書き込み、および98h〜9Bhいずれの読み出しでも `registerDataStored`（99hの1バイト目保持）を取り消す。
- 9Ah（パレット1バイト目）と9Bhの書き込みは保持を取り消さないが、共有の `dataLatch` を上書きする。パレット2バイト目のR/Bもこの `dataLatch` から取る。
- パレットのバイトカウンタ（`paletteDataStored`）はR#16書き込みでのみリセットされる。

### RTL変更（`vdp_cpu_interface.v`）

- 98h書き込み、またはいずれかのポートの読み出しで `ff_2nd_access` を0に戻す。
- 通常パレット（V9938形式）の1バイト目を `ff_1st_byte`（99h/9Bhと共有）に格納し、2バイト目でそこからR/Bを取り出すよう変更。
- 拡張パレットモード（R/G/B 3バイト）のカウンタは独立のまま、R#16書き込みで0に戻す挙動も維持。拡張パレットの書き込みは共有ラッチを変更しない。
- 実機でFleet Commander IIの起動を確認（ラッチ取り消し修正時点）。パレットのopenMSX準拠化は合成・実機未確認。

### テスト

- `test_vdp_cpu_interface/tb.sv` に `tb_port1_latch_reset` を追加（test001〜test012）。98h書き込み・98h読み出し・ステータス読み出しでの取り消し、9Ah/9Bh書き込みでの保持と値の置き換え、パレットR/Bの共有ラッチ参照、R#16およびステータス読み出しとパレットカウンタの関係、拡張パレットの独立性を確認。`run.bat` から実行するよう追加。
- ModelSimで全件エラー0。修正前RTLではtest002で失敗することを確認。既存の `tb_sprite_overmap_status` も通過。

### 注意点

- `test_vdp_cpu_interface` の既存 `tb` モジュールはDUTのポート構成が古く、vsimの読み込みで失敗する（今回の変更以前から）。
- 9Ahが共有ラッチを上書きする挙動はopenMSXの実装に準拠したもので、実機での裏付けは未確認。
- R#8のVR=0でCPUアドレスを16KB折り返す実装は、openMSX（CPU・コマンド・表示すべてに16KBマスクとアドレス入れ替え）と異なる。今回のゲームでは実際にはR#8が書き込まれないため影響なし。

## 2026-09-27 水平スクロール調査・修正

### 症状と調査

- 実機のロゴ表示に水平帯状の乱れが発生。R#27をBG側だけ8pixel境界で反映する変更では乱れが大きくなったため、BGとスプライトでR#27の反映タイミングを分けず、ライン単位に戻した。
- 改善後も数ラインに一度、前のR#26値が使われるように見える症状が報告された。残るずれは8pixel未満とのこと。
- 参考実装 `OTHERS/ocm-pld-dev/esemsx3/src/video` のV9958 VHDLを確認。R#26はCPU書込み値と表示側の有効値を分け、HSYNCパルスで有効化し、描画側は8ドットグループ先頭で座標に取り込む。R#27はSSGの表示開始位置補正とスプライト表示位置で別々に使用されていた。

### RTL変更

- `vdp_timing_control_ssg.v` のR#26/R#27有効値を、スクロール補正後のXが`-1 pixel`、最終サブフェーズとなる位置で同時にラッチするよう変更。
- イベント位置はラッチ済みR#27ではなく入力中の`reg_horizontal_offset_l`から計算する。これによりR#27を増減した場合も、新しい値に対応する次の表示開始直前に両レジスタを更新する。
- 旧R#26の8pixel境界ごとの更新はやめ、表示中は有効値を維持する。
- BGとスプライトには共通の`horizontal_offset_l`を使用する。ユーザー変更により低位ラッチ名は`ff_horizontal_offset_l`。

### テストと確認

- `test_vdp_timing_control_ssg/tb.sv` の`tb_scroll_group_alignment`で、R#26/R#27が表示中に変化しないこと、表示開始前に同時更新されることをR#27の0→3、3→0の両方向で確認。
- VRAM要求時の`ff_phase`とサブフェーズを検査し、SCREEN5のVRAMアドレスXグループがR#26/R#27適用後の期待座標と一致することを確認。
- `tb_scroll_midline`も同時ラッチの境界期待値に更新。
- ModelSimで両専用テストを実行し、コンパイル・シミュレーションともエラー0、警告0。編集ファイルの診断エラーなし。`git diff --check`も通過（CRLF正規化に関する警告のみ）。
- 実機では途中段階で乱れの改善と8pixel未満の残りずれが報告された。最終のR#26/R#27同時ラッチ変更後の実機確認、および全体回帰テストは未実施。

### 次回の注意点

- R#26は8pixel単位の高位オフセットなので、`w_pos_x[2:0]`だけを見るテストではR#26のアドレス群ずれを検出できない。VRAMアドレスのグループ番号と要求位相を直接照合する。
- R#27=0で表示開始直前のX=-1は、14bit座標では`14'h3FFF`。テスト期待値で符号付き折返しを考慮する。
- R#26/R#27のCPU書込み値と、描画に使うラッチ済み値を区別する。表示中の書込みが即時に描画へ反映される前提を置かない。
- R#27をBGだけ8pixel境界で切り替えると、VRAM取得位相と参照座標のグループがずれ得る。個別の表示系統だけ更新タイミングを変えない。

## 2026-09-27 共有VRAMキャッシュと映像の水平拡大

### 共有VRAMキャッシュ

- `vdp_command_cache.v`を32bitライン・8-way完全連想・LRU置換に変更。CPUとVDPコマンドの8bitアクセスを共通キャッシュへ通し、同時要求時はCPUを優先する。CPUアドレスはインターリーブ変換後にキャッシュへ渡す。
- CPUアクセスを受理するたび256クロックの無アクセスカウンタを再設定し、満了時に自動フラッシュする。コマンド終了時の明示フラッシュと完了通知も維持した。
- GowinのPnRでsetupスラック-5.388nsの違反を確認。インターリーブ設定からタグ比較・LRU選択・書き戻しアドレス選択までが同一サイクルに連なっていたため、要求の保持、ライン選択、データ処理をFFで分けた。8-wayは維持。
- `test_command_cache/tb.sv`でLRU、書きかけラインの読み出し、CPU/コマンド間の可視性と優先順位、256クロックタイマーの再設定・自動フラッシュを確認。FF追加後の全件回帰はModelSim Starter Editionでエラー0、警告0。
- FF追加後、ユーザーが合成時のタイミング違反解消とFPGA実機での期待どおりの動作を確認。

### 映像の水平拡大

- `vdp_video_out.v`はBresenham式の水平座標進行で前ラインの画素を読み、水平補間後に垂直2倍表示の走査線ゲインを適用する。非インターレースでは暗い画素ほど間のラインを暗くし、インターレースでは間のラインを黒にする。
- 同じ幅の縦縞がX位置により太さを変えて見える件を調査。上位の係数は約0～63だったが、`vdp_video_out_bilinear.v`は256分率として解釈していた。黒白境界の中間係数32では、期待する約128ではなく32/223が出ていた。
- 係数の取り出しを`w_normalized_numerator[14:7]`から`[12:5]`に変更。補間器や走査線ゲインは変更しない。中間係数128で黒→白、白→黒の出力がどちらも`0x80`となることをModelSimで確認。
- `test_vdp_video_out/tb.sv`に座標進行中の係数チェックを追加。映像テストはModelSim Starter Editionでエラー0、警告0。ユーザーが実機で見た目の明確な改善を確認。

### 注意点

- キャッシュを通らない画面・スプライト読み出しは、dirtyラインが書き戻されるまで更新前のVRAMを見る可能性がある。CPUの無アクセス時は256クロック後の自動フラッシュで書き戻される。
- 係数修正の前後で、水平座標進行と補間タップの位相を画素ごとに照合するテストは追加していない。必要になった場合は出力画素値を期待値と比較する。
