hra1129/V9968_Cartridge/(list of files, drawings)

Other design files:
pcb/vdp_cartridge_20k_2nd/vdp_cartridge.dsn
