hra1129/V9968_Cartridge/fpga/V9968_Cartridge_TangNano20K/impl/pnr/device.cfg

set JTAG regular_io = false
set SSPI regular_io = true
set MSPI regular_io = true
set READY regular_io = false
set DONE regular_io = false
set I2C regular_io = false
set RECONFIG_N regular_io = false
set CRC_check = true
set compress = true
set encryption = false
set security_bit_enable = true
set bsram_init_fuse_print = true
set secure_mode = false
set download_speed = 250/12
set program_done_bypass = false
set wake_up = 0
set format = binary
set power_on_reset_monitor = true
set multiboot_spi_flash_address = 0x00000000
set vccx = 3.3
set vcc = 1.0
set unused_pin = default
