hra1129/V9968_Cartridge/(commit log)

2026-02-01 Modified
    DVIモジュールのリセット信号を修正。
    たまに表示が乱れる問題が解消したかもしれない。
2026-02-23 Bugfix LRMM command
    以前の修正で、バグが混入していたのを修正
    [vdp_command.v]
2026-02-23 Bugfix VR bit on S#2
    垂直同期割り込み発生から少し遅れたタイミングで VR=1 になっていたバグを修正
    [vdp_command.v, vdp_timing_control_ssg.v]
2026-03-18 Removed
    28MHz 版はうまく動かないようなので、いったん削除。
    間違えてる BOM も削除。
    [A1man.CSV, animation.xlsx, bg_pl5.xlsx, bom.csv, color_convert.xlsx, count.xlsx, device.cfg, gamma.xlsx]
2026-06-02 Rename th9958 to v9968
    フォルダー名変更 th9958 → v9968
    [A1man.CSV, animation.xlsx, bg_pl5.xlsx, color_convert.xlsx, gamma.xlsx, logo3.xlsx, magnify.xlsx, rotate.xlsx]
2026-06-02 Bugfix
    回転コマンド LRMM が期待通り動かなくなっていたバグを修正。
    [vdp_command.v]
2026-06-02 Register R#20, R#21 Modified
    R#20, R#21 のビットマップを変更
2026-06-03 Added new function: Sprite Mode2 with PaletteSet# when EPAL bit = 1
    SpriteMode2 を使っているときに、EPAL=1 にすると、Attribute+3 の下位4bit が PaletteSet# の扱いになる機能を追加。
2026-06-03 Bugfix
    ブリンクテーブルのアドレスが間違えていたバグを修正
    ブリンク周期が半分になっていたのを修正
2026-06-04 Bugfix: Modified BLINK pattern process for SCREEN0:WIDTH80 (TEXT2)
    [vdp_timing_control_screen_mode.v]
2026-06-26 Bugfix
    S#10 を読むと VDP Command 完了割り込みをクリアする実装が残っていたバグを修正
    [tangnano20k_vdp_cartridge.v, vdp_cpu_interface.v]
2026-07-08 Modified
    配置配線のタイミングバイオレーション緩和のために、clone FF を追加。
2026-08-04 Added PORT#4 bit7
    bit7 = 0 : Unlock R#20 and R#21 registers (Writable)
    bit7 = 1 (default) : Lock R#20 and R#21 registers (NOT Writable)
    [device.cfg]
2026-11-08 v0.99
    FH の扱いを、v0.93 に戻した。
    スぺマン、ZANAC EX で表示がおかしくなる問題が解消。
2026-11-08 Manual 更新
2026-11-14 v0.99.7
    いろいろバグ修正
2026-11-14 Bugfix
    VRAM Write の化け解消
2026-11-14 SCREEN10～12 で周辺色がおかしいバグを修正
2026-11-14 SCREEN8, EPAL=0, SpriteMode3 の時の定義を修正
