hra1129/V9968_Cartridge/(notices)

Notices in the files:
pcb/vdp_cartridge_20k_2nd/vdp_cartridge.kicad_pcb:
Copyright 2025 HRA!
pcb/vdp_cartridge_20k_4th/vdp_cartridge.kicad_pcb:
Copyright 2026 HRA!
